CopperPilot/Jetson-AI-Cam-CopperPilot/docs/images/schematic-comparisons/page2_id_serial_after.png

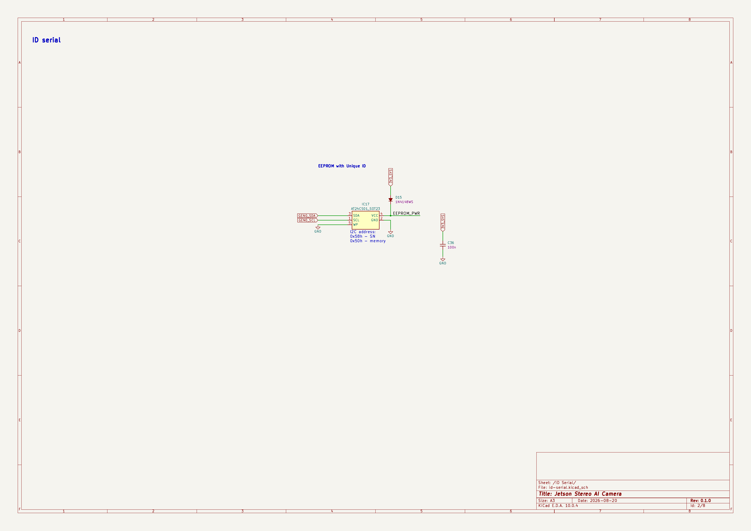
docs/images/schematic-comparisons/page2_id_serial_after.png
