CopperPilot/Jetson-AI-Cam-CopperPilot/docs/images/schematic-comparisons/page4_som_after.png

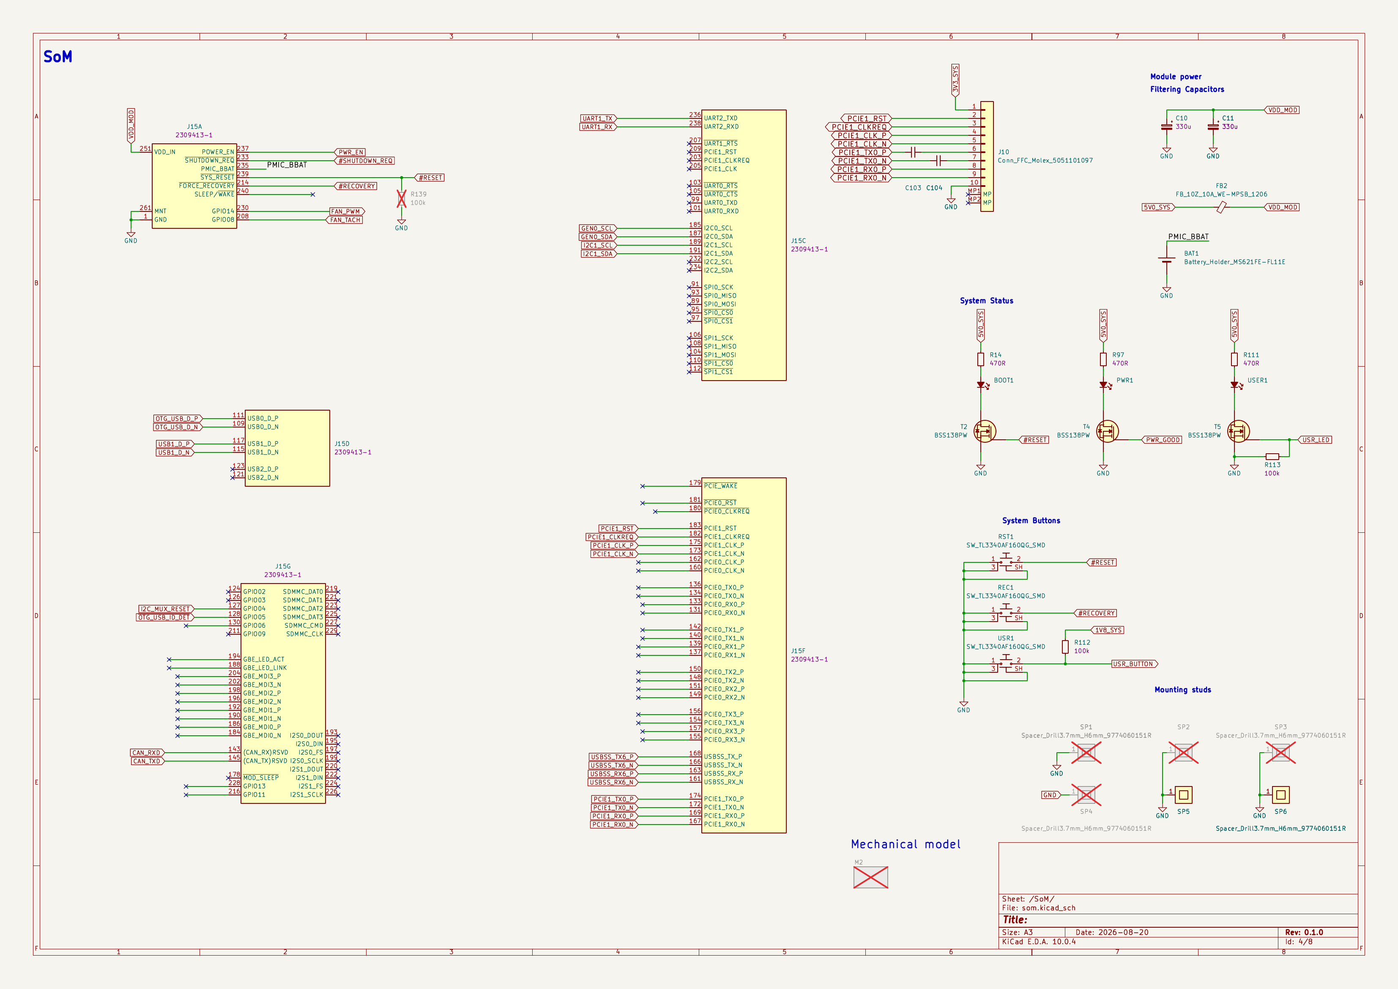
docs/images/schematic-comparisons/page4_som_after.png
