CopperPilot/Jetson-AI-Cam-CopperPilot/docs/images/schematic-comparisons/page6_supply_before.png

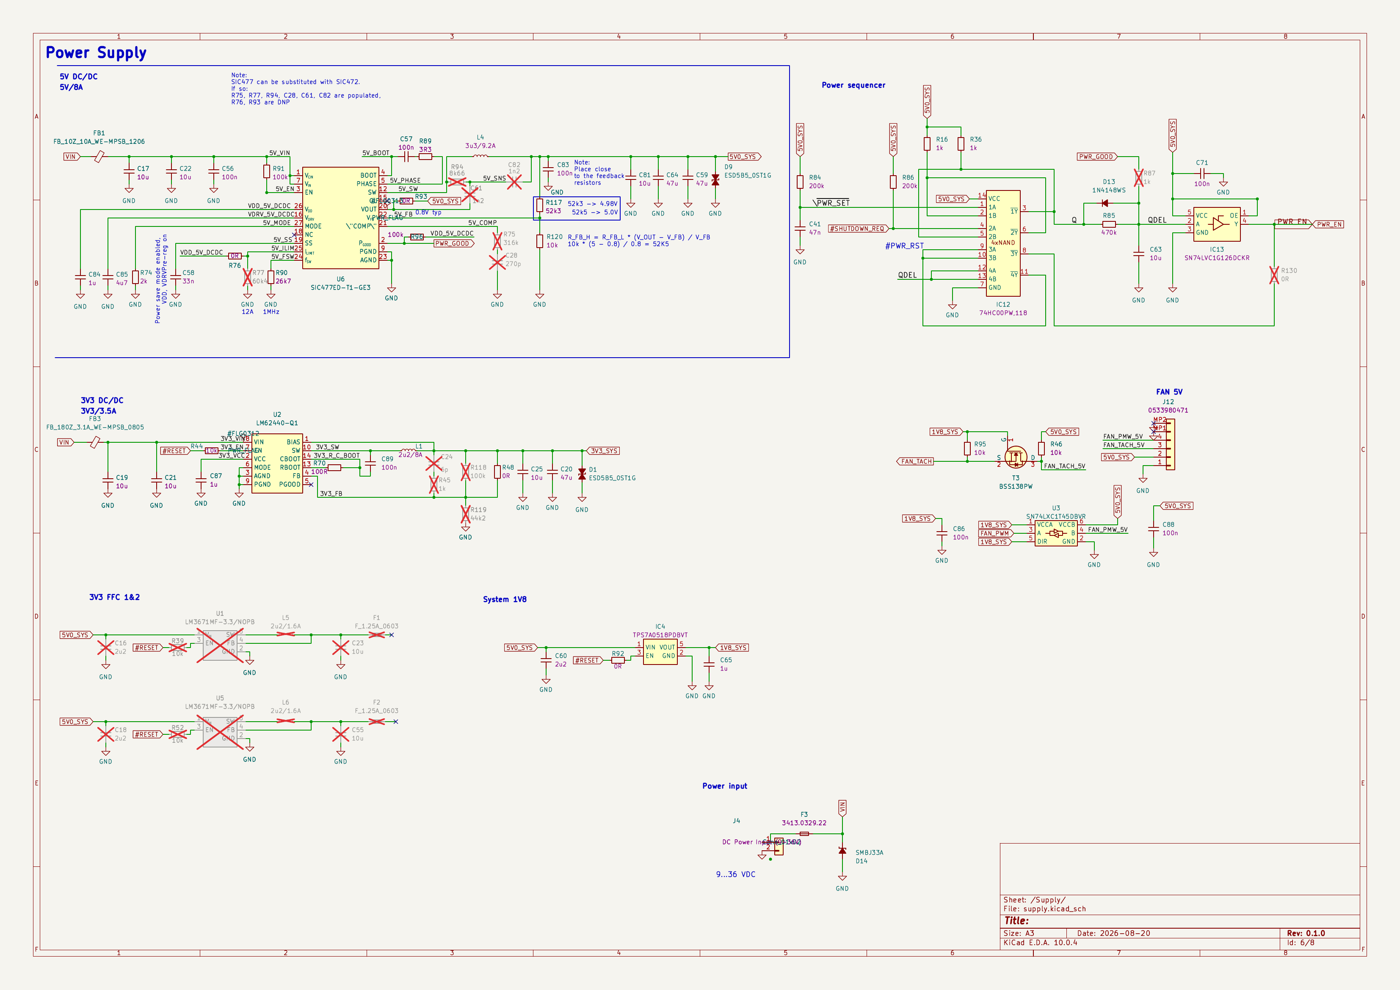
docs/images/schematic-comparisons/page6_supply_before.png
