CopperPilot/Jetson-AI-Cam-CopperPilot/docs/images/schematic-comparisons/page7_interfaces_after.png

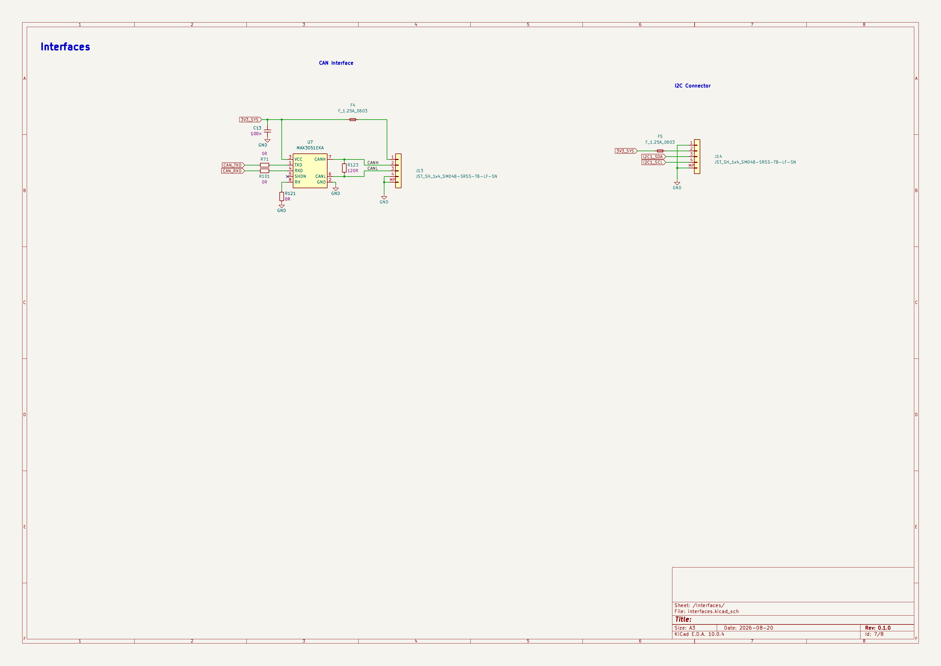
docs/images/schematic-comparisons/page7_interfaces_after.png
