CopperPilot/Jetson-AI-Cam-CopperPilot/docs/images/schematic-comparisons/page7_interfaces_comparison.png

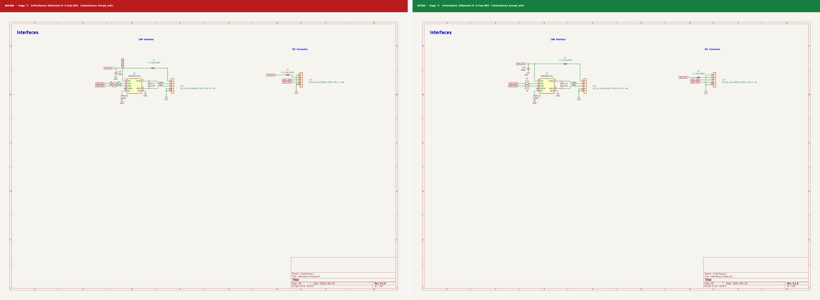
docs/images/schematic-comparisons/page7_interfaces_comparison.png
