CopperPilot/Jetson-AI-Cam-CopperPilot/review/renders/baseline/pcb_09_F_Mask.png

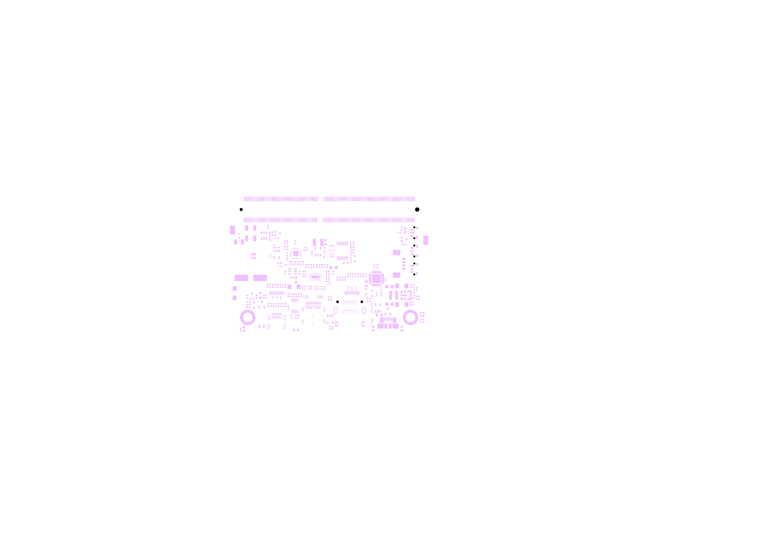
review/renders/baseline/pcb_09_F_Mask.png
