CopperPilot/Jetson-AI-Cam-CopperPilot/review/renders/baseline/sch_01_Root.png

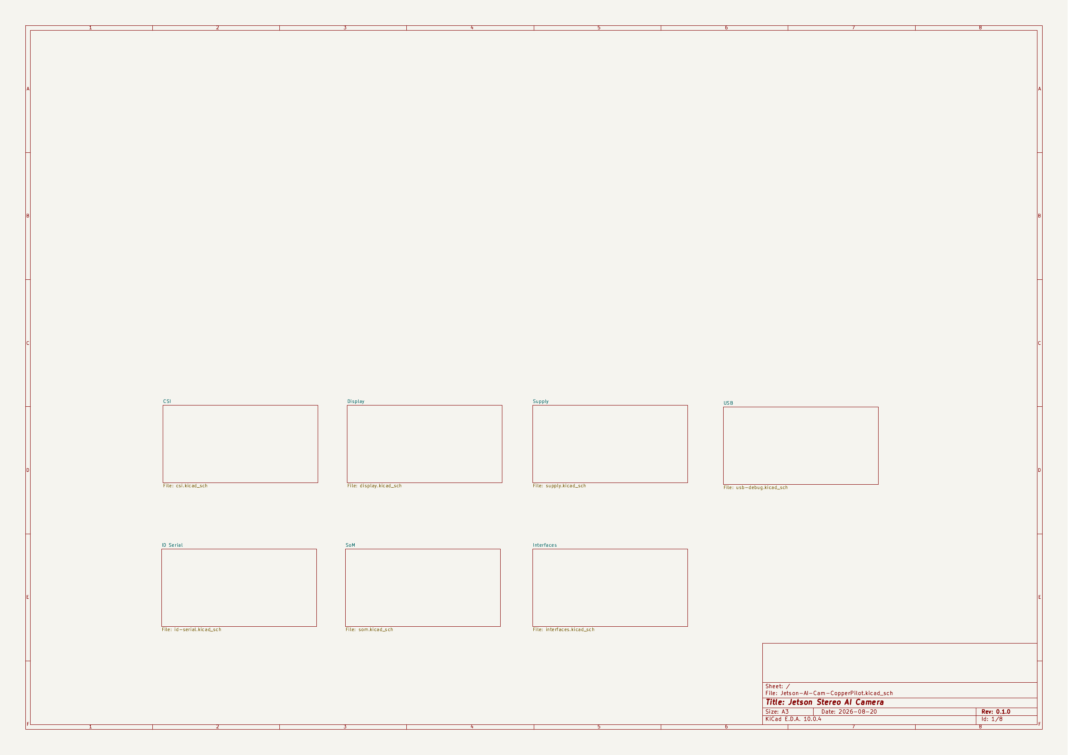
review/renders/baseline/sch_01_Root.png
