CopperPilot/Jetson-AI-Cam-CopperPilot/review/renders/baseline/sch_05_Display.png

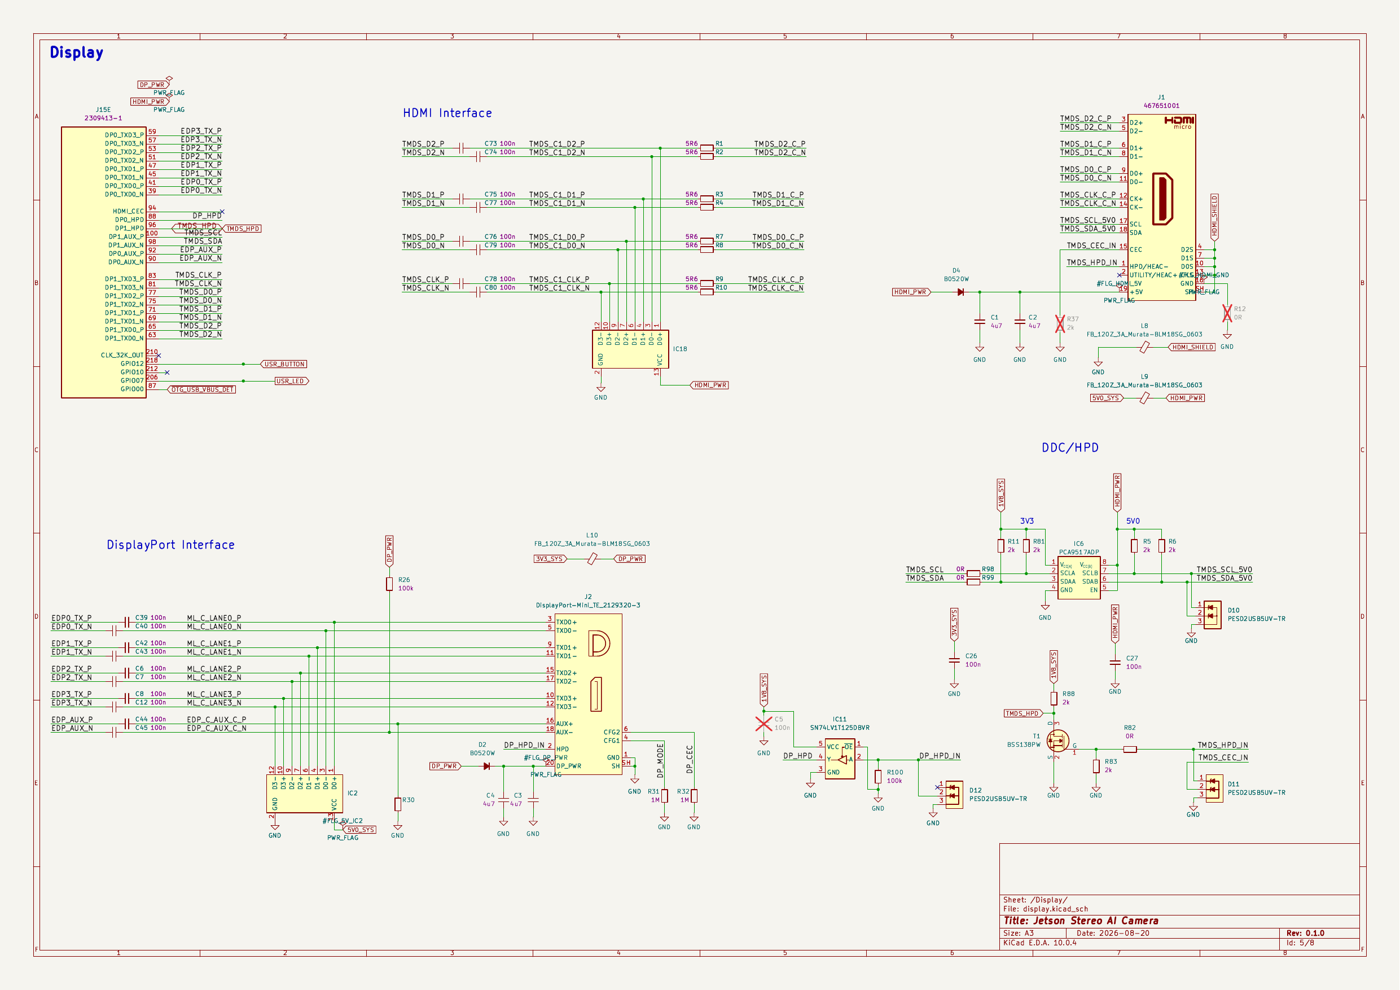
review/renders/baseline/sch_05_Display.png
