CopperPilot/Jetson-AI-Cam-CopperPilot/review/renders/deep_dive/3d_bottom_4k.png

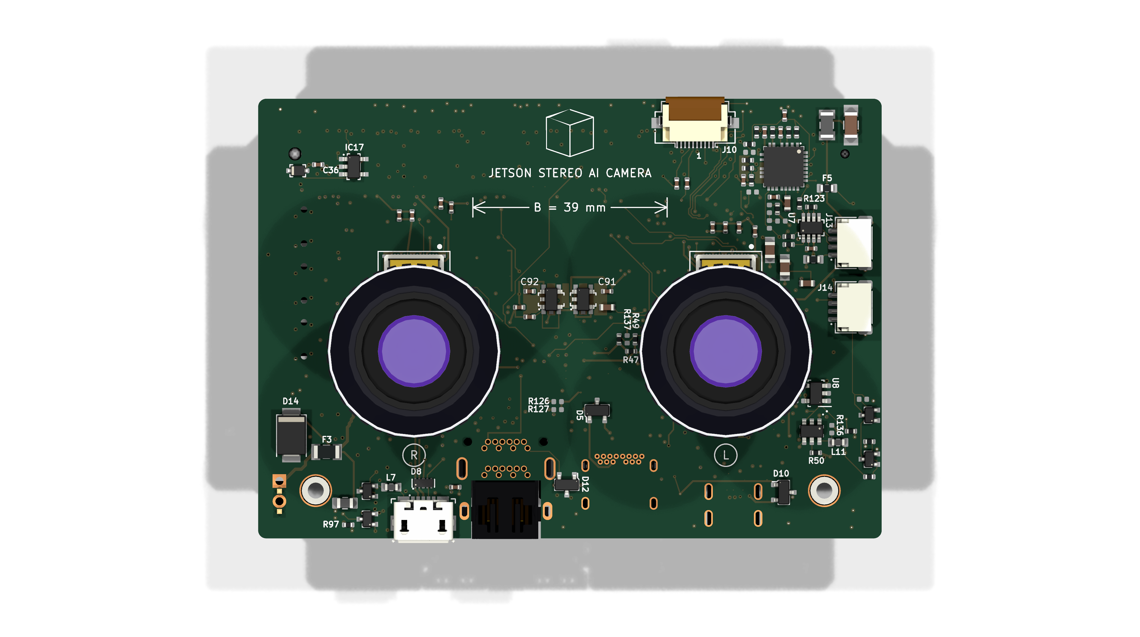
review/renders/deep_dive/3d_bottom_4k.png
