CopperPilot/Jetson-AI-Cam-CopperPilot/review/renders/deep_dive/zones/zone1_power_dc_dc_F_SilkS.png

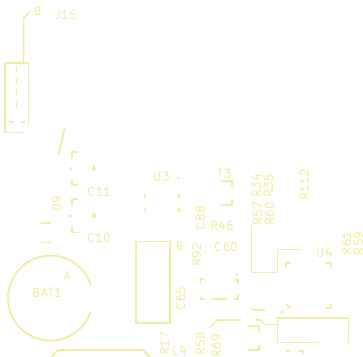
review/renders/deep_dive/zones/zone1_power_dc_dc_F_SilkS.png
