CopperPilot/Jetson-AI-Cam-CopperPilot/review/renders/deep_dive/zones/zone3_video_dp_hdmi_3D_Bottom.png

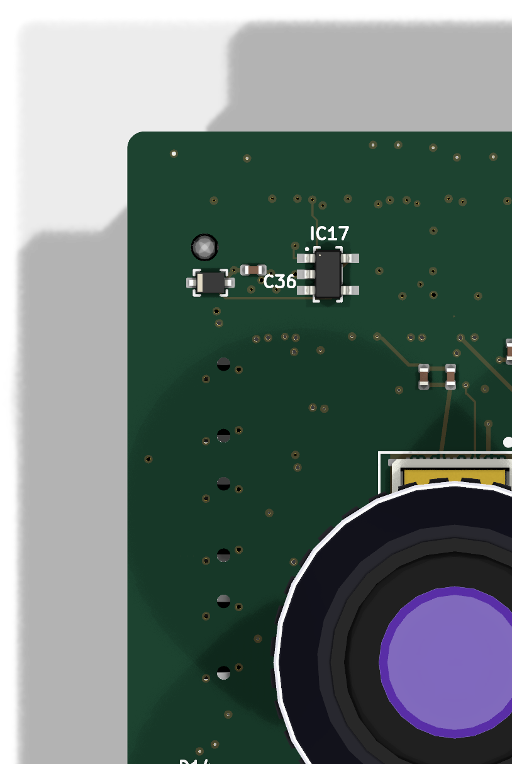
review/renders/deep_dive/zones/zone3_video_dp_hdmi_3D_Bottom.png
