CopperPilot/Jetson-AI-Cam-CopperPilot/review/renders/deep_dive/zones/zone3_video_dp_hdmi_In2_Signal.png

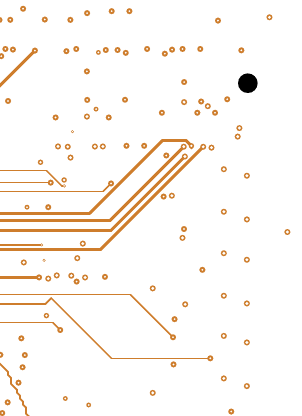
review/renders/deep_dive/zones/zone3_video_dp_hdmi_In2_Signal.png
