CopperPilot/Jetson-AI-Cam-CopperPilot/review/renders/deep_dive/zones/zone4_cameras_mipi_csi_In4_GND.png

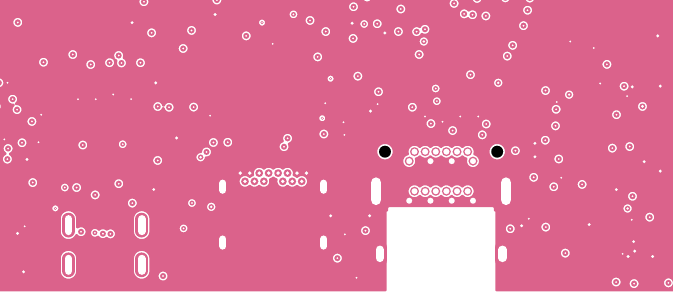
review/renders/deep_dive/zones/zone4_cameras_mipi_csi_In4_GND.png
