CopperPilot/Jetson-AI-Cam-CopperPilot/review/renders/deep_dive/zones/zone6_can_peripherals_F_Cu.png

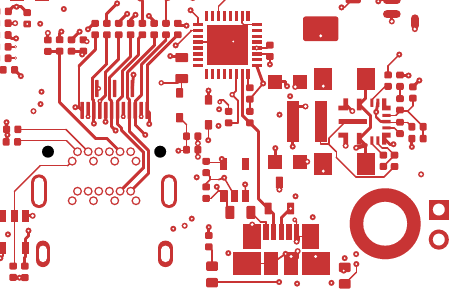
review/renders/deep_dive/zones/zone6_can_peripherals_F_Cu.png
