CopperPilot/Jetson-AI-Cam-CopperPilot/review/renders/deep_dive/zones/zone6_can_peripherals_In4_GND.png

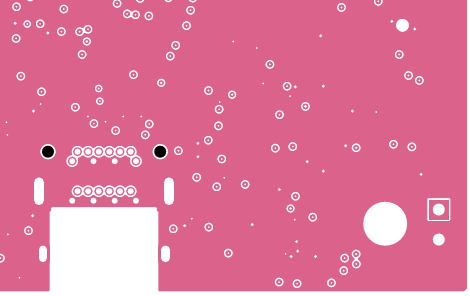
review/renders/deep_dive/zones/zone6_can_peripherals_In4_GND.png
