CopperPilot/Jetson-AI-Cam-CopperPilot/review/renders/diff/pcb_03_In2_Cu.png

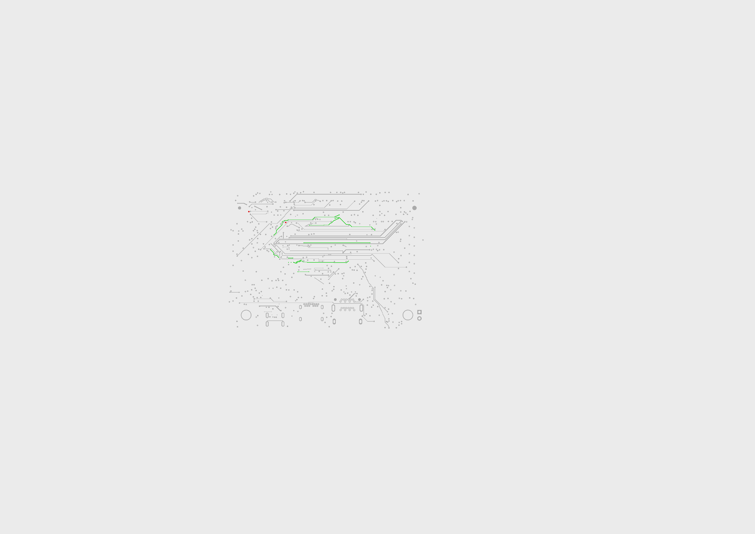
review/renders/diff/pcb_03_In2_Cu.png
