CopperPilot/Jetson-AI-Cam-CopperPilot/review/renders/diff/pcb_05_In4_Cu.png

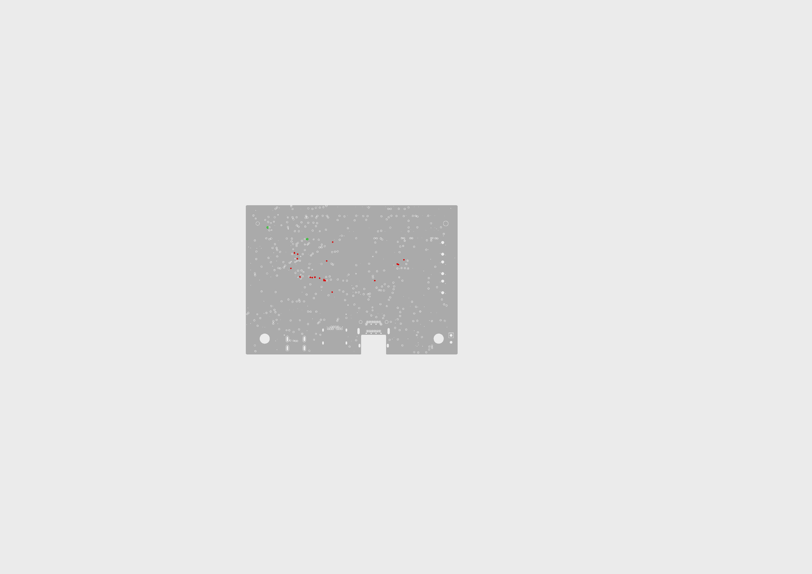
review/renders/diff/pcb_05_In4_Cu.png
