CopperPilot/Jetson-AI-Cam-CopperPilot/review/renders/diff/sch_01_Root.png

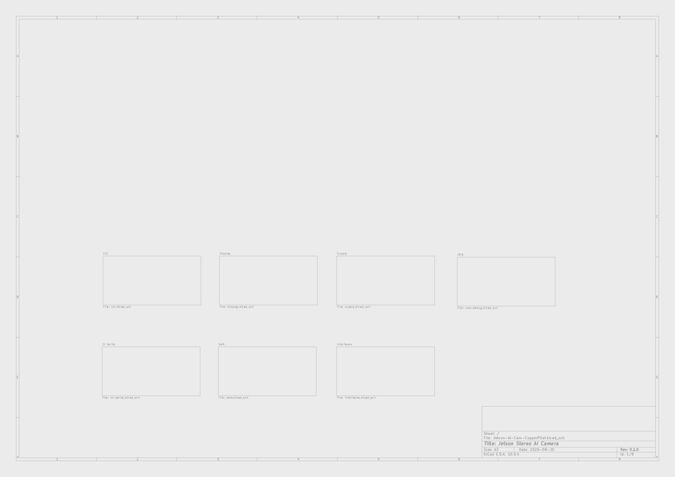
review/renders/diff/sch_01_Root.png
