CopperPilot/Jetson-AI-Cam-CopperPilot/review/renders/diff/sch_02_ID_Serial.png

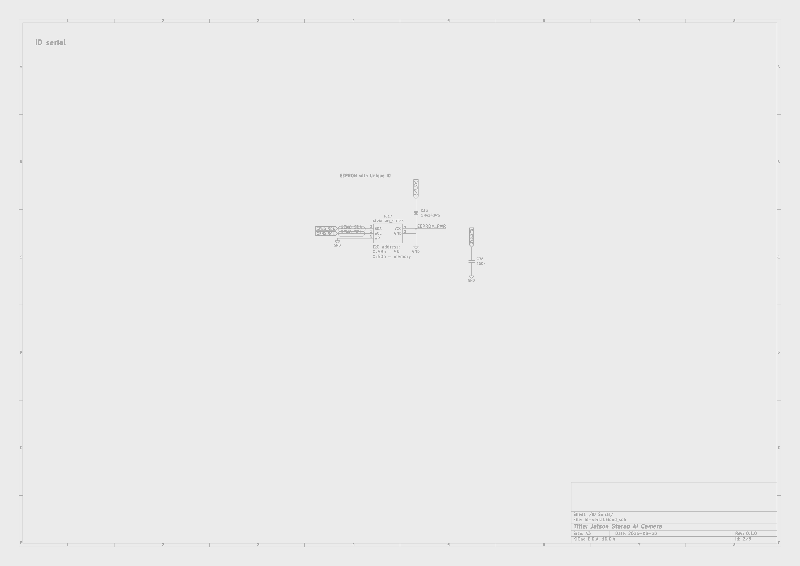
review/renders/diff/sch_02_ID_Serial.png
