CopperPilot/Jetson-AI-Cam-CopperPilot/review/renders/diff/sch_03_Interfaces.png

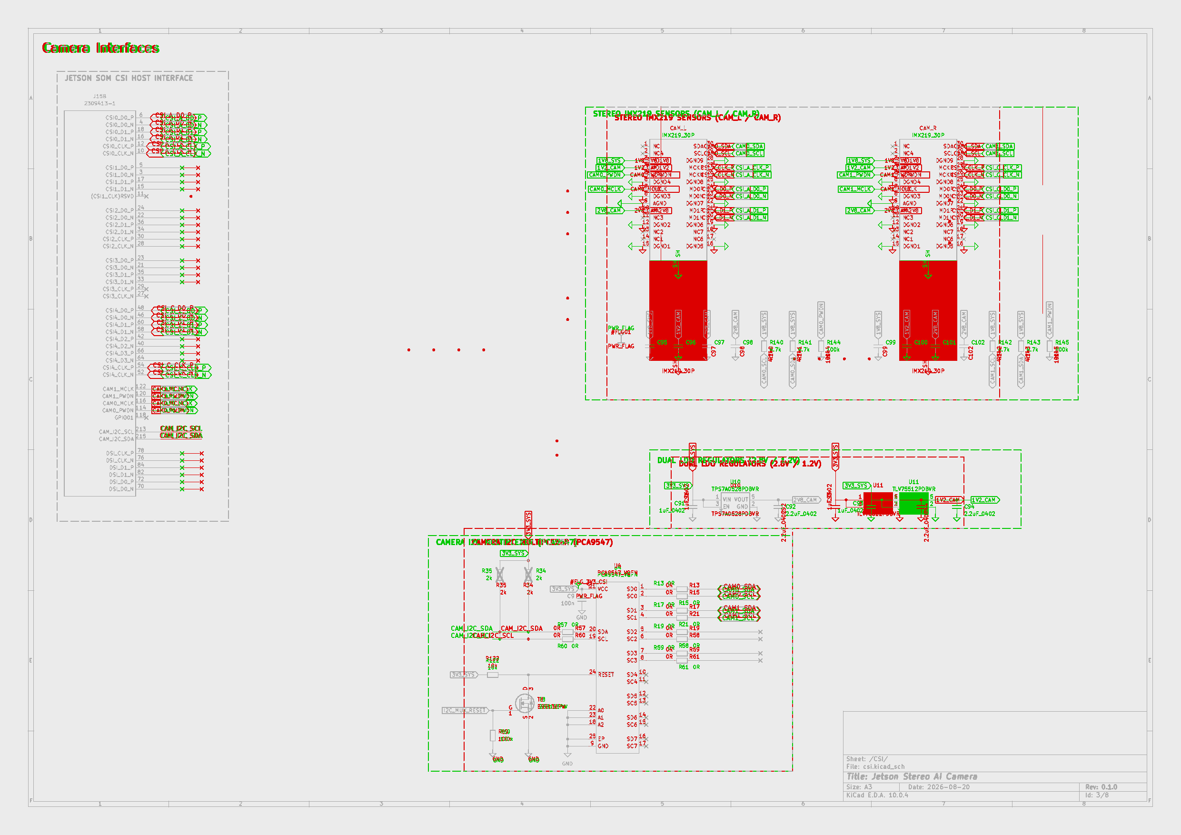
review/renders/diff/sch_03_Interfaces.png
