CopperPilot/Jetson-AI-Cam-CopperPilot/review/renders/diff/sch_04_SoM.png

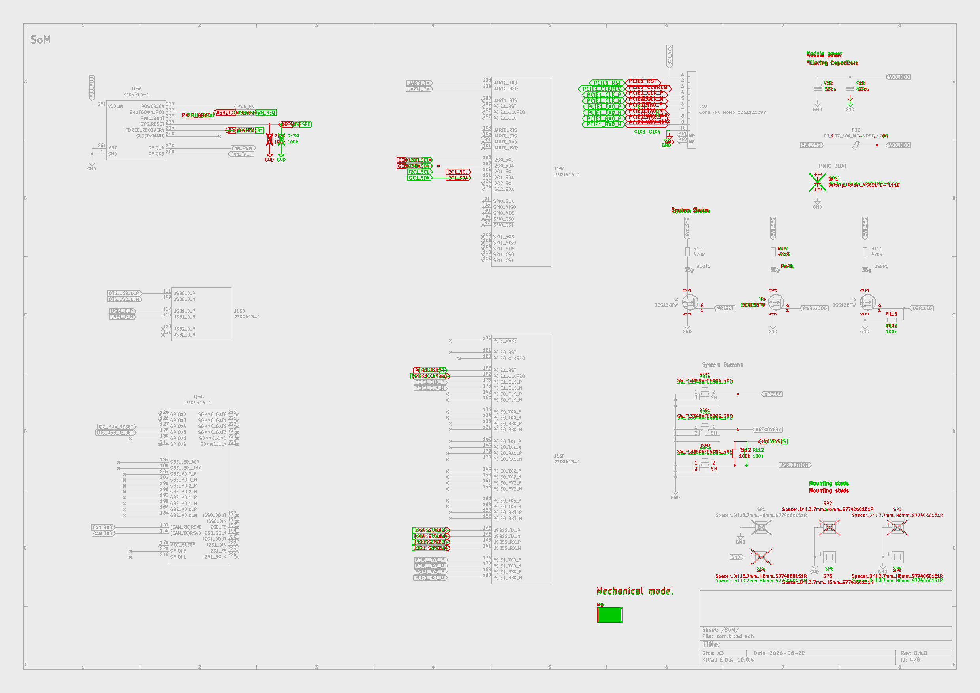
review/renders/diff/sch_04_SoM.png
