CopperPilot/Jetson-AI-Cam-CopperPilot/review/renders/diff/sch_06_Supply.png

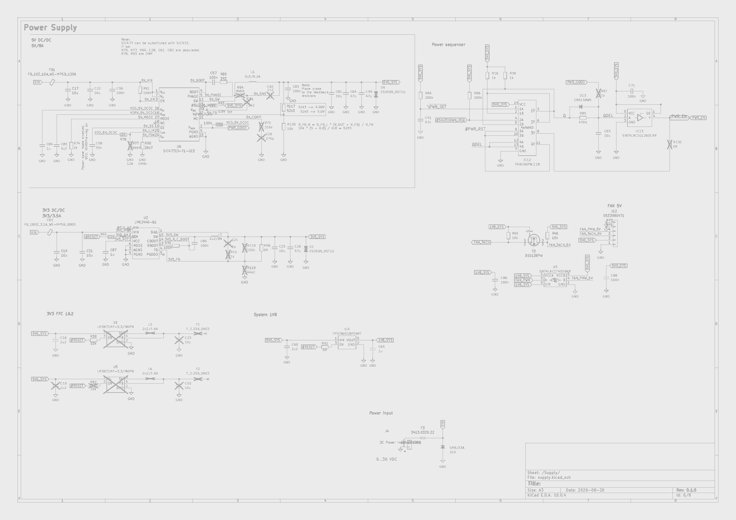
review/renders/diff/sch_06_Supply.png
