CopperPilot/Jetson-AI-Cam-CopperPilot/review/renders/diff/sch_07_CSI.png

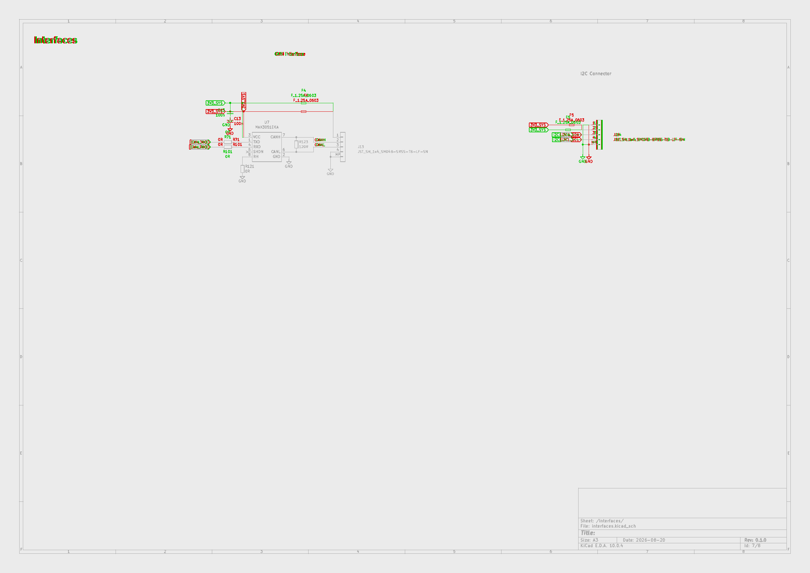
review/renders/diff/sch_07_CSI.png
