CopperPilot/Jetson-AI-Cam-CopperPilot/review/renders/diff/sch_08_USB.png

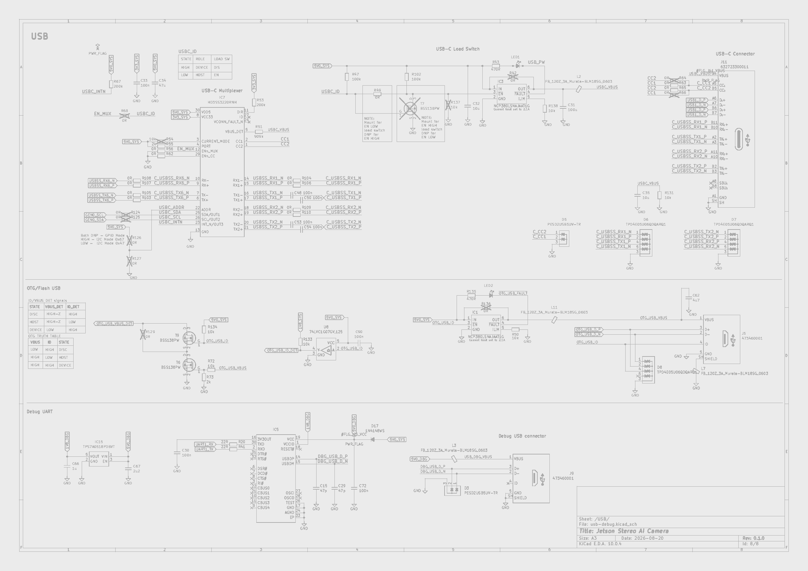
review/renders/diff/sch_08_USB.png
