CopperPilot/Jetson-AI-Cam-CopperPilot/review/renders/final/sch_01_Root.png

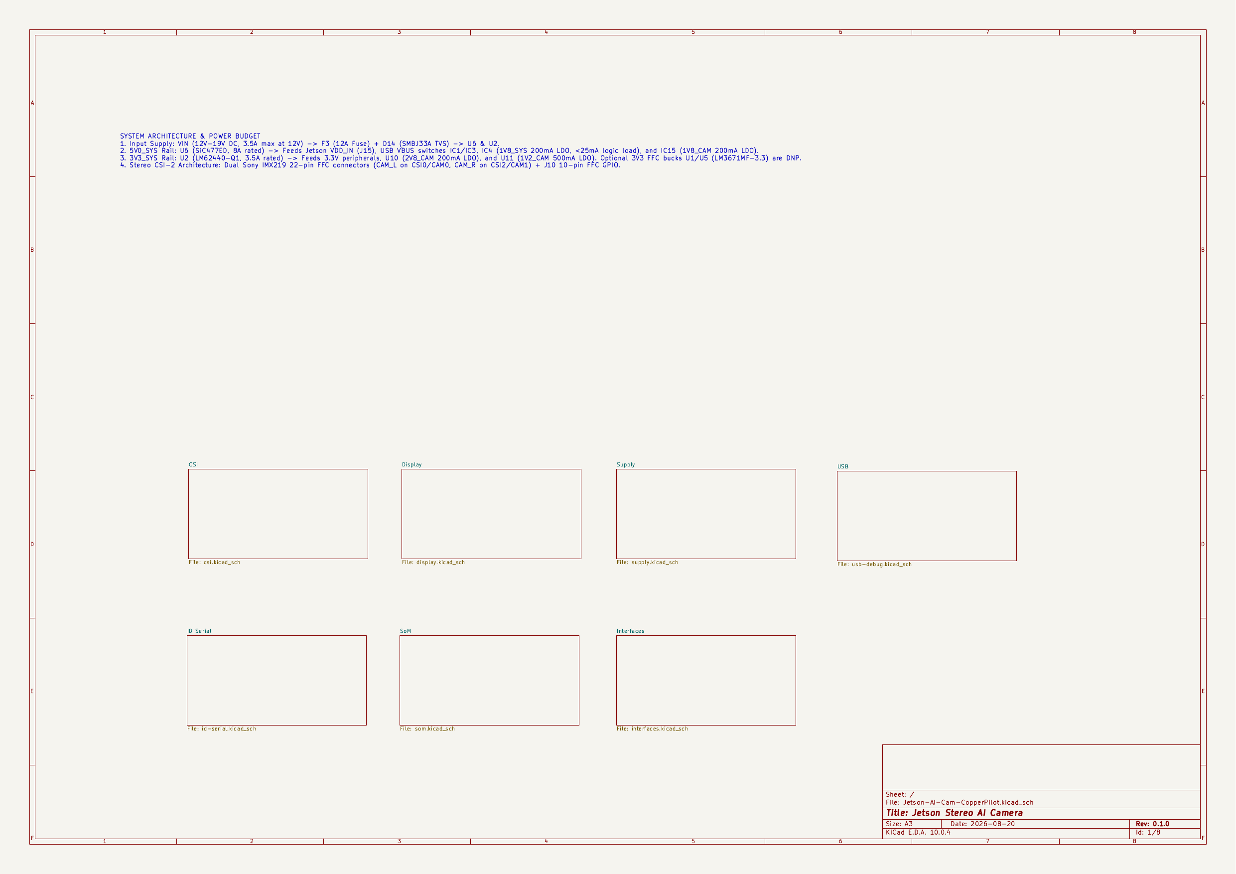
review/renders/final/sch_01_Root.png
