CopperPilot/Jetson-AI-Cam-CopperPilot/review/renders/final/sch_02_ID_Serial.png

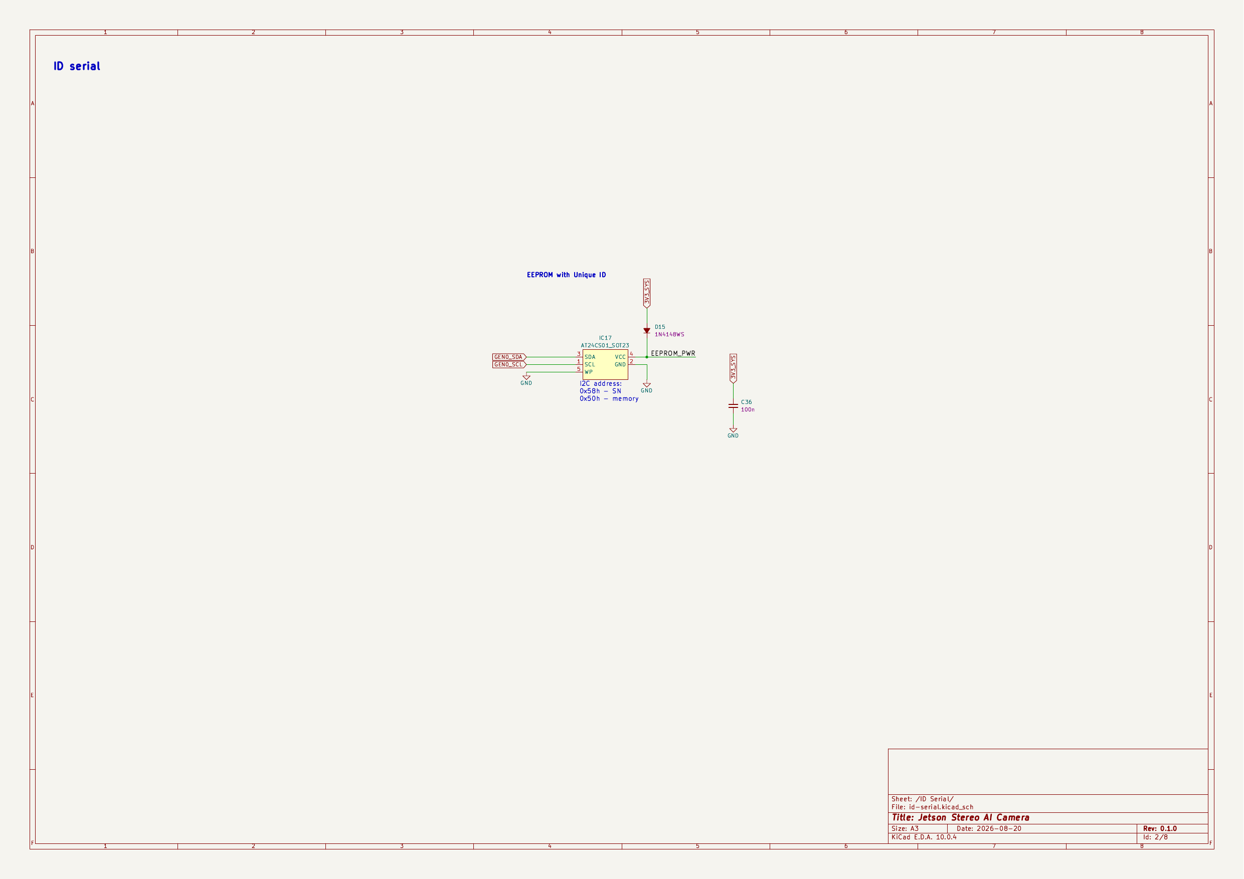
review/renders/final/sch_02_ID_Serial.png
