CopperPilot/Jetson-AI-Cam-CopperPilot/jlcpcb/Jetson-AI-Cam-CopperPilot-bom.csv

Designator | Value | Footprint | LCSC | MPN | DNP
BOOT1 | LED_G_0603_LG_L29K-G2J1-24-Z | jetson-footprints:LED_0603_1608Metric_G | C72043 | LG L29K-G2J1-24-Z
C1 | C_4u7_0402 | jetson-footprints:C_0402_1005Metric | C23733 | GRM155R61A475MEAAD
C2 | C_4u7_0402 | jetson-footprints:C_0402_1005Metric | C23733 | GRM155R61A475MEAAD
C3 | C_4u7_0402 | jetson-footprints:C_0402_1005Metric | C23733 | GRM155R61A475MEAAD
C4 | C_4u7_0402 | jetson-footprints:C_0402_1005Metric | C23733 | GRM155R61A475MEAAD
C5 | C_100n_0402 | jetson-footprints:C_0402_1005Metric | C1525 | GRM155R61H104KE14D
C6 | C_100n_0402 | jetson-footprints:C_0402_1005Metric | C1525 | GRM155R61H104KE14D
C7 | C_100n_0402 | jetson-footprints:C_0402_1005Metric | C1525 | GRM155R61H104KE14D
C8 | C_100n_0402 | jetson-footprints:C_0402_1005Metric | C1525 | GRM155R61H104KE14D
C9 | C_100n_0402 | jetson-footprints:C_0402_1005Metric | C1525 | GRM155R61H104KE14D
C10 | C_Pol_330u_6.3V_KEMET-T520-B | jetson-footprints:C_Pol_EIA-B | C134785 | T520B337M006ATE040
C11 | C_Pol_330u_6.3V_KEMET-T520-B | jetson-footprints:C_Pol_EIA-B | C134785 | T520B337M006ATE040
C12 | C_100n_0402 | jetson-footprints:C_0402_1005Metric | C1525 | GRM155R61H104KE14D
C13 | C_100n_0402 | jetson-footprints:C_0402_1005Metric | C1525 | GRM155R61H104KE14D
C15 | C_47p_0402 | jetson-footprints:C_0402_1005Metric | C1548 | C0402C470J5GACTU
C17 | C_10u_1206_50V | jetson-footprints:C_1206_3216Metric | C13585 | C3216X7R1H106K160AE
C19 | C_10u_1206_50V | jetson-footprints:C_1206_3216Metric | C13585 | C3216X7R1H106K160AE
C20 | C_47u_0805 | jetson-footprints:C_0805_2012Metric | C16780 | C0805C476M9PACTU
C21 | C_10u_1206_50V | jetson-footprints:C_1206_3216Metric | C13585 | C3216X7R1H106K160AE
C22 | C_10u_1206_50V | jetson-footprints:C_1206_3216Metric | C13585 | C3216X7R1H106K160AE
C24 | C_6p_0402 | jetson-footprints:C_0402_1005Metric | C1571 | 0402N6R0D500CT
C25 | C_10u_0805 | jetson-footprints:C_0805_2012Metric | C15850 | 160R15X106KV4E
C26 | C_100n_0402 | jetson-footprints:C_0402_1005Metric | C1525 | GRM155R61H104KE14D
C27 | C_100n_0402 | jetson-footprints:C_0402_1005Metric | C1525 | GRM155R61H104KE14D
C29 | C_47p_0402 | jetson-footprints:C_0402_1005Metric | C1548 | C0402C470J5GACTU
C30 | C_100n_0402 | jetson-footprints:C_0402_1005Metric | C1525 | GRM155R61H104KE14D
C31 | C_100u_1206 | jetson-footprints:C_1206_3216Metric | C15068 | GRM31CR60J107MEA8K
C32 | C_10u_0402 | jetson-footprints:C_0402_1005Metric | C15525 | CC0402MRX5R5BB106
C33 | C_100n_0402 | jetson-footprints:C_0402_1005Metric | C1525 | GRM155R61H104KE14D
C34 | C_47u_0805 | jetson-footprints:C_0805_2012Metric | C16780 | C0805C476M9PACTU
C35 | C_10u_0603 | jetson-footprints:C_0603_1608Metric | C19702 | GRM188R61A106KE69D
C36 | C_100n_0402 | jetson-footprints:C_0402_1005Metric | C1525 | GRM155R61H104KE14D
C39 | C_100n_0402 | jetson-footprints:C_0402_1005Metric | C1525 | GRM155R61H104KE14D
C40 | C_100n_0402 | jetson-footprints:C_0402_1005Metric | C1525 | GRM155R61H104KE14D
C41 | C_47n_0402 | jetson-footprints:C_0402_1005Metric | C1536 | GRM155R71C473KA01D
C42 | C_100n_0402 | jetson-footprints:C_0402_1005Metric | C1525 | GRM155R61H104KE14D
C43 | C_100n_0402 | jetson-footprints:C_0402_1005Metric | C1525 | GRM155R61H104KE14D
C44 | C_100n_0402 | jetson-footprints:C_0402_1005Metric | C1525 | GRM155R61H104KE14D
C45 | C_100n_0402 | jetson-footprints:C_0402_1005Metric | C1525 | GRM155R61H104KE14D
C48 | C_100n_0402 | jetson-footprints:C_0402_1005Metric | C1525 | GRM155R61H104KE14D
C50 | C_100n_0402 | jetson-footprints:C_0402_1005Metric | C1525 | GRM155R61H104KE14D
C53 | C_100n_0402 | jetson-footprints:C_0402_1005Metric | C1525 | GRM155R61H104KE14D
C54 | C_100n_0402 | jetson-footprints:C_0402_1005Metric | C1525 | GRM155R61H104KE14D
C56 | C_100n_50V_0402 | jetson-footprints:C_0402_1005Metric | C307331 | GRM155R71H104KE14D
C57 | C_100n_0402 | jetson-footprints:C_0402_1005Metric | C1525 | GRM155R61H104KE14D
C58 | C_33n_0402 | jetson-footprints:C_0402_1005Metric | C1533 | GCM155R71E333KA55D
C59 | C_47u_0805 | jetson-footprints:C_0805_2012Metric | C16780 | C0805C476M9PACTU
C60 | C_2u2_0402 | jetson-footprints:C_0402_1005Metric | C12530 | C1005X5R1A225K050BC
C62 | C_4u7_0402 | jetson-footprints:C_0402_1005Metric | C23733 | GRM155R61A475MEAAD
C63 | C_10u_0603 | jetson-footprints:C_0603_1608Metric | C19702 | GRM188R61A106KE69D
C64 | C_47u_0805 | jetson-footprints:C_0805_2012Metric | C16780 | C0805C476M9PACTU
C65 | C_1u_0402 | jetson-footprints:C_0402_1005Metric | C52923 | C1005X6S1A105K050BC
C66 | C_1u_0402 | jetson-footprints:C_0402_1005Metric | C52923 | C1005X6S1A105K050BC
C67 | C_2u2_0402 | jetson-footprints:C_0402_1005Metric | C12530 | C1005X5R1A225K050BC
C71 | C_100n_0402 | jetson-footprints:C_0402_1005Metric | C1525 | GRM155R61H104KE14D
C72 | C_100n_0402 | jetson-footprints:C_0402_1005Metric | C1525 | GRM155R61H104KE14D
C73 | C_100n_0402 | jetson-footprints:C_0402_1005Metric | C1525 | GRM155R61H104KE14D
C74 | C_100n_0402 | jetson-footprints:C_0402_1005Metric | C1525 | GRM155R61H104KE14D
C75 | C_100n_0402 | jetson-footprints:C_0402_1005Metric | C1525 | GRM155R61H104KE14D
C76 | C_100n_0402 | jetson-footprints:C_0402_1005Metric | C1525 | GRM155R61H104KE14D
C77 | C_100n_0402 | jetson-footprints:C_0402_1005Metric | C1525 | GRM155R61H104KE14D
C78 | C_100n_0402 | jetson-footprints:C_0402_1005Metric | C1525 | GRM155R61H104KE14D
C79 | C_100n_0402 | jetson-footprints:C_0402_1005Metric | C1525 | GRM155R61H104KE14D
C80 | C_100n_0402 | jetson-footprints:C_0402_1005Metric | C1525 | GRM155R61H104KE14D
C81 | C_10u_0603 | jetson-footprints:C_0603_1608Metric | C19702 | GRM188R61A106KE69D
C83 | C_100n_0402 | jetson-footprints:C_0402_1005Metric | C1525 | GRM155R61H104KE14D
C84 | C_1u_0402 | jetson-footprints:C_0402_1005Metric | C52923 | C1005X6S1A105K050BC
C85 | C_4u7_0603 | jetson-footprints:C_0603_1608Metric | C19666 | C1608X5R1V475M080AC
C86 | C_100n_0402 | jetson-footprints:C_0402_1005Metric | C1525 | GRM155R61H104KE14D
C87 | C_1u_0402 | jetson-footprints:C_0402_1005Metric | C52923 | C1005X6S1A105K050BC
C88 | C_100n_0402 | jetson-footprints:C_0402_1005Metric | C1525 | GRM155R61H104KE14D
C89 | C_100n_0402 | jetson-footprints:C_0402_1005Metric | C1525 | GRM155R61H104KE14D
C90 | C_100n_0402 | jetson-footprints:C_0402_1005Metric | C1525 | GRM155R61H104KE14D
C91 | 1uF_0402 | jetson-footprints:C_0402_1005Metric | C52923 | C1005X6S1A105K050BC
C92 | 2.2uF_0402 | jetson-footprints:C_0402_1005Metric | C12530 | C1005X5R1A225K050BC
C93 | 1uF_0402 | jetson-footprints:C_0402_1005Metric | C52923 | C1005X6S1A105K050BC
C94 | 2.2uF_0402 | jetson-footprints:C_0402_1005Metric | C12530 | C1005X5R1A225K050BC
C95 | C_100n_0402 | jetson-footprints:C_0402_1005Metric | C1525 | GRM155R61H104KE14D
C96 | C_100n_0402 | jetson-footprints:C_0402_1005Metric | C1525 | GRM155R61H104KE14D
C97 | C_100n_0402 | jetson-footprints:C_0402_1005Metric | C1525 | GRM155R61H104KE14D
C98 | C_2u2_0402 | jetson-footprints:C_0402_1005Metric | C12530 | C1005X5R1A225K050BC
C99 | C_100n_0402 | jetson-footprints:C_0402_1005Metric | C1525 | GRM155R61H104KE14D
C100 | C_100n_0402 | jetson-footprints:C_0402_1005Metric | C1525 | GRM155R61H104KE14D
C101 | C_100n_0402 | jetson-footprints:C_0402_1005Metric | C1525 | GRM155R61H104KE14D
C102 | C_2u2_0402 | jetson-footprints:C_0402_1005Metric | C12530 | C1005X5R1A225K050BC
C103 | C_100n_0402 | jetson-footprints:C_0402_1005Metric | C1525 | GRM155R61H104KE14D
C104 | C_100n_0402 | jetson-footprints:C_0402_1005Metric | C1525 | GRM155R61H104KE14D
CAM_L | IMX219_30P | jetson-footprints:Camera_Module_IMX219-D160 | C424662 | BM20B(0.8)-30DS-0.4V(51)
CAM_R | IMX219_30P | jetson-footprints:Camera_Module_IMX219-D160 | C424662 | BM20B(0.8)-30DS-0.4V(51)
D1 | ESD5B5_0ST1G | jetson-footprints:SOD-523_NP | C15906 | ESD5B5.0ST1G
D2 | B0520W | jetson-footprints:D_SOD-323F | C8598 | B0520W
D3 | PESD2USB5UV-TR | jetson-footprints:SOT-23-3 | C2827695 | PESD2USB5UV-TR
D4 | B0520W | jetson-footprints:D_SOD-323F | C8598 | B0520W
D5 | PESD2USB5UV-TR | jetson-footprints:SOT-23-3 | C2827695 | PESD2USB5UV-TR
D6 | TPD4E05U06QDQARQ1 | jetson-footprints:USON-10_2.5x1mm_P0.5mm | C138252 | TPD4E05U06QDQARQ1
D7 | TPD4E05U06QDQARQ1 | jetson-footprints:USON-10_2.5x1mm_P0.5mm | C138252 | TPD4E05U06QDQARQ1
D8 | TPD4E05U06QDQARQ1 | jetson-footprints:USON-10_2.5x1mm_P0.5mm | C138252 | TPD4E05U06QDQARQ1
D9 | ESD5B5_0ST1G | jetson-footprints:SOD-523_NP | C15906 | ESD5B5.0ST1G
D10 | PESD2USB5UV-TR | jetson-footprints:SOT-23-3 | C2827695 | PESD2USB5UV-TR
D11 | PESD2USB5UV-TR | jetson-footprints:SOT-23-3 | C2827695 | PESD2USB5UV-TR
D12 | PESD2USB5UV-TR | jetson-footprints:SOT-23-3 | C2827695 | PESD2USB5UV-TR
D13 | 1N4148WS | jetson-footprints:D_SOD-323F | C2128 | 1N4148WS
D14 | SMBJ33A | jetson-footprints:D_SMB | C123805 | SMBJ33A
D15 | 1N4148WS | jetson-footprints:D_SOD-323F | C2128 | 1N4148WS
D17 | 1N4148WS | jetson-footprints:D_SOD-323F | C2128 | 1N4148WS
F3 | F_12A_1206 | jetson-footprints:F_1206_3216Metric | C269188 | 3413.0329.22
F4 | F_1.25A_0603 | jetson-footprints:F_0603_1608Metric | C150891 | 04671.25NR
F5 | F_1.25A_0603 | jetson-footprints:F_0603_1608Metric | C150891 | 04671.25NR
FB1 | FB_10Z_10A_WE-MPSB_1206 | jetson-footprints:FB_1206_3216Metric | C145764 | 74279221100
FB2 | FB_10Z_10A_WE-MPSB_1206 | jetson-footprints:FB_1206_3216Metric | C145764 | 74279221100
FB3 | FB_180Z_3.1A_WE-MPSB_0805 | jetson-footprints:FB_0805_2012Metric | C145762 | 74279220181
IC1 | NCP380LSNAJAAT1G | jetson-footprints:SOT-23-6 | C140656 | NCP380LSNAJAAT1G
IC2 | TPD8S009DSMR | jetson-footprints:R-PDSO-N15 | C139543 | TPD8S009DSMR
IC3 | NCP380LSNAJAAT1G | jetson-footprints:SOT-23-6 | C140656 | NCP380LSNAJAAT1G
IC4 | TPS7A0518P_SOT23-5 | jetson-footprints:SOT-23-5 | C194385 | TPS7A0518PDBVT
IC5 | FT232R_QFN | jetson-footprints:QFN-32-1EP_5x5mm | C51997 | FT232RQ-REEL
IC6 | PCA9517ADP | jetson-footprints:TSSOP-8_3x3mm_P0.65mm | C112457 | PCA9517ADP
IC7 | HD3SS3220RNH | jetson-footprints:WQFN-30-1EP_4.6x2.6mm_P0.4mm | C131361 | HD3SS3220RNHT
IC11 | SN74LV1T125DBVR | jetson-footprints:SOT-23-5 | C100024 | SN74LV1T125DBVR
IC12 | 74HC00_TSSOP | jetson-footprints:TSSOP-14_4.4x5mm_P0.65mm | C7062 | 74HC00PW,118
IC13 | SN74LVC1G126_SC-70 | jetson-footprints:SC-70-5 | C7823 | SN74LVC1G126DCKR
IC15 | TPS7A0518P_SOT23-5 | jetson-footprints:SOT-23-5 | C194385 | TPS7A0518PDBVT
IC17 | AT24CS01_SOT23 | jetson-footprints:SOT-23-5 | C500682 | AT24CS01-ST
IC18 | TPD8S009DSMR | jetson-footprints:R-PDSO-N15 | C139543 | TPD8S009DSMR
J1 | HDMI-Micro-D_Molex_467561001 | jetson-footprints:HDMI-Micro-D_Receptacle_Molex_467651001 | C563878 | 467651001
J2 | DisplayPort-Mini_TE_2129320-3 | jetson-footprints:DisplayPort-Mini_Receptacle_TE_2129320-3 | C574827 | 2129320-3
J4 | Conn_01x02 | jetson-footprints:PinHeader_1x02_P2.54mm_Vertical | C492401 | TSW-102-07-L-S
J5 | USB-Micro-B_Molex_473460001 | jetson-footprints:USB-Micro-B_Receptacle_Molex_473460001 | C132560 | 473460001
J9 | USB-Micro-B_Molex_473460001 | jetson-footprints:USB-Micro-B_Receptacle_Molex_473460001 | C132560 | 473460001
J10 | Conn_FFC_Molex_5051101097 | jetson-footprints:Conn_FFC_Molex_5051101097 | C283651 | 5051101097
J11 | USB-C_WE_632723300011 | jetson-footprints:USB-C_Receptacle_WE_632723300011 | C456013 | 632723300011
J12 | Molex_PicoBlade_1x4_0533980471 | jetson-footprints:Conn_Molex_PicoBlade_1x4_0533980471 | C134090 | 0533980471
J13 | JST_SH_1x4_SM04B-SRSS-TB-LF-SN | jetson-footprints:Conn_JST_SH_1x4_SM04B-SRSS-TB-LF-SN | C160404 | SM04B-SRSS-TB(LF)(SN)
J14 | JST_SH_1x4_SM04B-SRSS-TB-LF-SN | jetson-footprints:Conn_JST_SH_1x4_SM04B-SRSS-TB-LF-SN | C160404 | SM04B-SRSS-TB(LF)(SN)
J15 | Bus_DDR4_SODIMM_CUSTOM_Jetson-Nano-H9.2mm-socket | jetson-footprints:TE_2309413 | C2766246 | 2309413-1
L1 | L_2u2_8A_Coilcraft-XFL4020 | jetson-footprints:L_Coilcraft-XFL4020 | C503516 | XFL4020-222MEC
L2 | FB_120Z_3A_Murata-BLM18SG_0603 | jetson-footprints:FB_0603_1608Metric | C73884 | BLM18SG121TN1D
L3 | FB_120Z_3A_Murata-BLM18SG_0603 | jetson-footprints:FB_0603_1608Metric | C73884 | BLM18SG121TN1D
L4 | L_3u3_9.2A_Vishay-IHLP-3232DZ-01 | jetson-footprints:L_Vishay-IHLP3232DZ | C139365 | IHLP3232DZER3R3M01
L7 | FB_120Z_3A_Murata-BLM18SG_0603 | jetson-footprints:FB_0603_1608Metric | C73884 | BLM18SG121TN1D
L8 | FB_120Z_3A_Murata-BLM18SG_0603 | jetson-footprints:FB_0603_1608Metric | C73884 | BLM18SG121TN1D
L9 | FB_120Z_3A_Murata-BLM18SG_0603 | jetson-footprints:FB_0603_1608Metric | C73884 | BLM18SG121TN1D
L10 | FB_120Z_3A_Murata-BLM18SG_0603 | jetson-footprints:FB_0603_1608Metric | C73884 | BLM18SG121TN1D
L11 | FB_120Z_3A_Murata-BLM18SG_0603 | jetson-footprints:FB_0603_1608Metric | C73884 | BLM18SG121TN1D
LED1 | LED_G_0603_LG_L29K-G2J1-24-Z | jetson-footprints:LED_0603_1608Metric_G | C72043 | LG L29K-G2J1-24-Z
LED2 | LED_G_0603_LG_L29K-G2J1-24-Z | jetson-footprints:LED_0603_1608Metric_G | C72043 | LG L29K-G2J1-24-Z
PWR1 | LED_G_0603_LG_L29K-G2J1-24-Z | jetson-footprints:LED_0603_1608Metric_G | C72043 | LG L29K-G2J1-24-Z
R1 | R_5R6_0402 | jetson-footprints:R_0402_1005Metric | C25122 | CR0402-FX-5R60GLF
R2 | R_5R6_0402 | jetson-footprints:R_0402_1005Metric | C25122 | CR0402-FX-5R60GLF
R3 | R_5R6_0402 | jetson-footprints:R_0402_1005Metric | C25122 | CR0402-FX-5R60GLF
R4 | R_5R6_0402 | jetson-footprints:R_0402_1005Metric | C25122 | CR0402-FX-5R60GLF
R5 | R_2k_0402 | jetson-footprints:R_0402_1005Metric | C4109 | CR0402-FX-2001GLF
R6 | R_2k_0402 | jetson-footprints:R_0402_1005Metric | C4109 | CR0402-FX-2001GLF
R7 | R_5R6_0402 | jetson-footprints:R_0402_1005Metric | C25122 | CR0402-FX-5R60GLF
R8 | R_5R6_0402 | jetson-footprints:R_0402_1005Metric | C25122 | CR0402-FX-5R60GLF
R9 | R_5R6_0402 | jetson-footprints:R_0402_1005Metric | C25122 | CR0402-FX-5R60GLF
R10 | R_5R6_0402 | jetson-footprints:R_0402_1005Metric | C25122 | CR0402-FX-5R60GLF
R11 | R_2k_0402 | jetson-footprints:R_0402_1005Metric | C4109 | CR0402-FX-2001GLF
R13 | R_0R_0402 | jetson-footprints:R_0402_1005Metric | C17168 | ERJ2GE0R00X
R14 | R_470R_0402 | jetson-footprints:R_0402_1005Metric | C25117 | CR0402-FX-4700GLF
R15 | R_0R_0402 | jetson-footprints:R_0402_1005Metric | C17168 | ERJ2GE0R00X
R16 | R_1k_0402 | jetson-footprints:R_0402_1005Metric | C11702 | CR0402-FX-1001GLF
R17 | R_0R_0402 | jetson-footprints:R_0402_1005Metric | C17168 | ERJ2GE0R00X
R19 | R_0R_0402 | jetson-footprints:R_0402_1005Metric | C17168 | ERJ2GE0R00X
R20 | R_22R_0402 | jetson-footprints:R_0402_1005Metric | C25092 | CR0402-FX-22R0GLF
R21 | R_0R_0402 | jetson-footprints:R_0402_1005Metric | C17168 | ERJ2GE0R00X
R26 | R_100k_0402 | jetson-footprints:R_0402_1005Metric | C25741 | CR0402-FX-1003GLF
R30 | R_100k_0402 | jetson-footprints:R_0402_1005Metric | C25741 | CR0402-FX-1003GLF
R31 | R_1M_0402 | jetson-footprints:R_0402_1005Metric | C26083 | CR0402-FX-1004GLF
R32 | R_1M_0402 | jetson-footprints:R_0402_1005Metric | C26083 | CR0402-FX-1004GLF
R36 | R_1k_0402 | jetson-footprints:R_0402_1005Metric | C11702 | CR0402-FX-1001GLF
R41 | R_22R_0402 | jetson-footprints:R_0402_1005Metric | C25092 | CR0402-FX-22R0GLF
R43 | R_470R_0402 | jetson-footprints:R_0402_1005Metric | C25117 | CR0402-FX-4700GLF
R44 | R_10k_0402 | jetson-footprints:R_0402_1005Metric | C25744 | CR0402-FX-1002GLF
R45 | R_1k_0402 | jetson-footprints:R_0402_1005Metric | C11702 | CR0402-FX-1001GLF
R46 | R_10k_0402 | jetson-footprints:R_0402_1005Metric | C25744 | CR0402-FX-1002GLF
R47 | R_100k_0402 | jetson-footprints:R_0402_1005Metric | C25741 | CR0402-FX-1003GLF
R49 | R_0R_0402 | jetson-footprints:R_0402_1005Metric | C17168 | ERJ2GE0R00X
R50 | R_10k_0402 | jetson-footprints:R_0402_1005Metric | C25744 | CR0402-FX-1002GLF
R51 | R_909k_0402 | jetson-footprints:R_0402_1005Metric | C25788 | CR0402-FX-9093GLF
R53 | R_200k_0402 | jetson-footprints:R_0402_1005Metric | C25764 | CR0402-FX-2003GLF
R55 | R_2k_0402 | jetson-footprints:R_0402_1005Metric | C4109 | CR0402-FX-2001GLF
R56 | R_0R_0402 | jetson-footprints:R_0402_1005Metric | C17168 | ERJ2GE0R00X
R57 | R_0R_0402 | jetson-footprints:R_0402_1005Metric | C17168 | ERJ2GE0R00X
R58 | R_0R_0402 | jetson-footprints:R_0402_1005Metric | C17168 | ERJ2GE0R00X
R59 | R_0R_0402 | jetson-footprints:R_0402_1005Metric | C17168 | ERJ2GE0R00X
R60 | R_0R_0402 | jetson-footprints:R_0402_1005Metric | C17168 | ERJ2GE0R00X
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
R133 | R_10k_0402 | jetson-footprints:R_0402_1005Metric | C25744 | CR0402-FX-1002GLF
R134 | R_10k_0402 | jetson-footprints:R_0402_1005Metric | C25744 | CR0402-FX-1002GLF
R135 | R_470R_0402 | jetson-footprints:R_0402_1005Metric | C25117 | CR0402-FX-4700GLF
R138 | R_10k_0402 | jetson-footprints:R_0402_1005Metric | C25744 | CR0402-FX-1002GLF
R140 | 4.7k | jetson-footprints:R_0402_1005Metric | C25900 | CR0402-FX-4701GLF
R141 | 4.7k | jetson-footprints:R_0402_1005Metric | C25900 | CR0402-FX-4701GLF
R142 | 4.7k | jetson-footprints:R_0402_1005Metric | C25900 | CR0402-FX-4701GLF
R143 | 4.7k | jetson-footprints:R_0402_1005Metric | C25900 | CR0402-FX-4701GLF
R144 | 100k | jetson-footprints:R_0402_1005Metric | C25741 | CR0402-FX-1003GLF
R145 | 100k | jetson-footprints:R_0402_1005Metric | C25741 | CR0402-FX-1003GLF
REC1 | SW_TL3340AF160QG_SMD | jetson-footprints:SW_TL3340AF160QG_SMD | C2886925 | TL3340AF160QG
RST1 | SW_TL3340AF160QG_SMD | jetson-footprints:SW_TL3340AF160QG_SMD | C2886925 | TL3340AF160QG
SP5 | Spacer_Drill3.7mm_H6mm_9774060151R | jetson-footprints:Spacer_Drill3.7mm_H6mm_9774060151R | C289551 | 9774060151R
SP6 | Spacer_Drill3.7mm_H6mm_9774060151R | jetson-footprints:Spacer_Drill3.7mm_H6mm_9774060151R | C289551 | 9774060151R
T1 | BSS138PW | jetson-footprints:SC70-3 | C84617 | BSS138PW
T2 | BSS138PW | jetson-footprints:SC70-3 | C84617 | BSS138PW
T3 | BSS138PW | jetson-footprints:SC70-3 | C84617 | BSS138PW
T4 | BSS138PW | jetson-footprints:SC70-3 | C84617 | BSS138PW
T5 | BSS138PW | jetson-footprints:SC70-3 | C84617 | BSS138PW
T6 | BSS138PW | jetson-footprints:SC70-3 | C84617 | BSS138PW
T8 | BSS138PW | jetson-footprints:SC70-3 | C84617 | BSS138PW
T9 | BSS138PW | jetson-footprints:SC70-3 | C84617 | BSS138PW
U2 | LM62440-Q1 | jetson-footprints:VQFN-HR-14_3.5x4mm | C524861 | LMQ62440BPPQRJRRQ1
U3 | SN74LXC1T45DBVR | jetson-footprints:SOT-23-6 | C2685415 | SN74LXC1T45DBVR
U4 | PCA9547_VQFN | jetson-footprints:VQFN-24-1EP_3.8x3.8x1.0mm_P0.5mm | C138804 | PCA9547BS,118
U6 | SIC477ED-T1-GE3 | jetson-footprints:SIC47XED-T1-GE3 | C516241 | SIC477ED-T1-GE3
U7 | MAX3051EKA | jetson-footprints:SOT-23-8 | C90741 | MAX3051EKA
U8 | 74LVC1G07_SOT-753 | jetson-footprints:SOT-753 | C7829 | 74LVC1G07GV,125
U10 | TPS7A0528PDBVR | jetson-footprints:SOT-23-5 | C194387 | TPS7A0528PDBVR
U11 | TLV75512PDBVR | jetson-footprints:SOT-23-5 | C485675 | TLV75512PDBVR
USER1 | LED_G_0603_LG_L29K-G2J1-24-Z | jetson-footprints:LED_0603_1608Metric_G | C72043 | LG L29K-G2J1-24-Z
USR1 | SW_TL3340AF160QG_SMD | jetson-footprints:SW_TL3340AF160QG_SMD | C2886925 | TL3340AF160QG
