CopperPilot/Jetson-AI-Cam-CopperPilot/3dmodels/Camera_Module_IMX219-M12.step

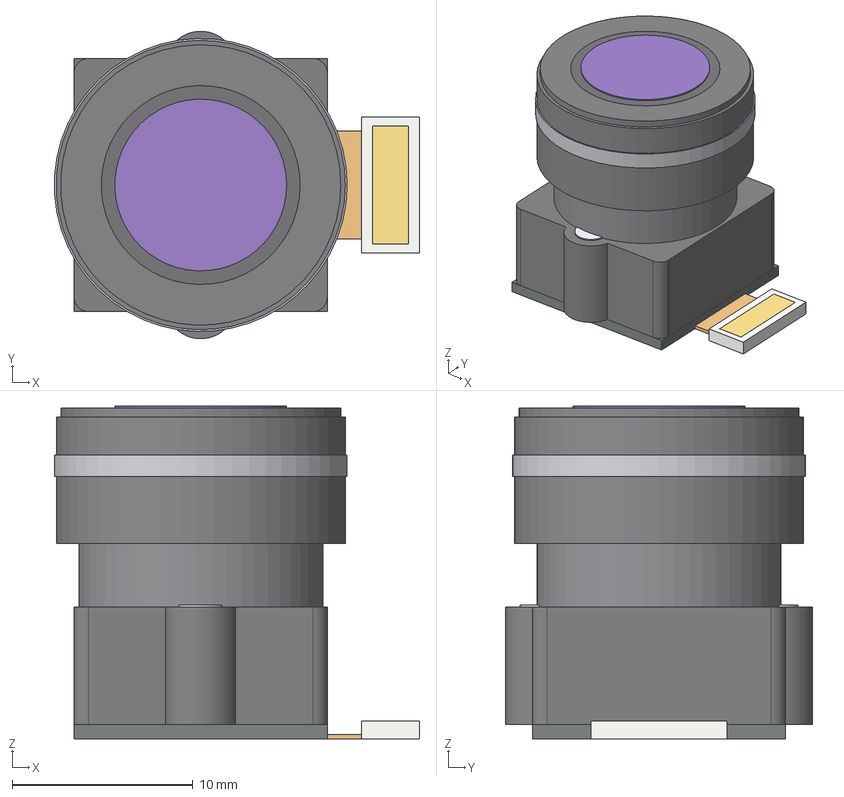
[picture p30: CAD file, 2026-10-06]
3dmodels/Camera_Module_IMX219-M12.step
20.2 x 17.0 x 18.4 mm
connector_nylon
connector_gold
flex_cable
sensor_pcb
lens_holder
mounting_screws
threaded_barrel
accent_ring
knurled_lens
inner_bezel
optical_glass
