CopperPilot/Jetson-AI-Cam-CopperPilot/3dmodels/MODULE_NVIDIA_JETSON-NANO.stl

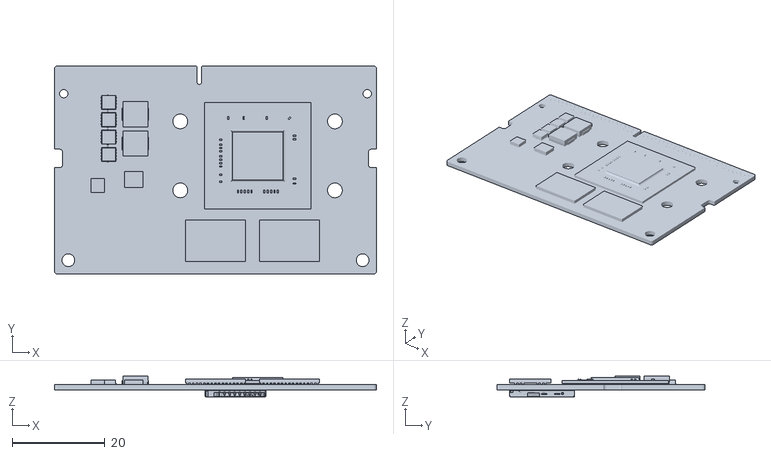
[picture p31: CAD file, 2026-10-02]
3dmodels/MODULE_NVIDIA_JETSON-NANO.stl
69.6 x 45.0 x 4.48
