CopperPilot/Jetson-AI-Cam-CopperPilot/3dmodels/test_m2.step

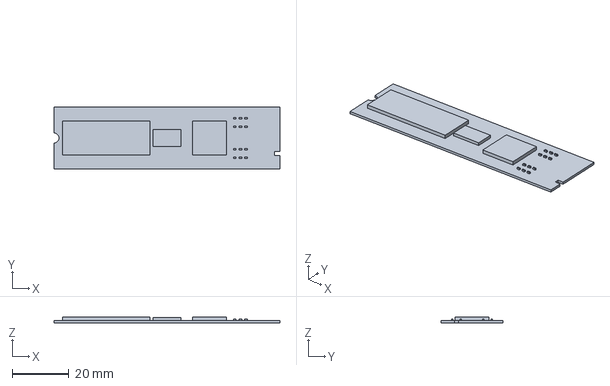
[picture p32: CAD file, 2026-10-02]
3dmodels/test_m2.step
80.0 x 22.0 x 2.00 mm
