CopperPilot/Jetson-AI-Cam-CopperPilot/3dmodels/9774040151.step

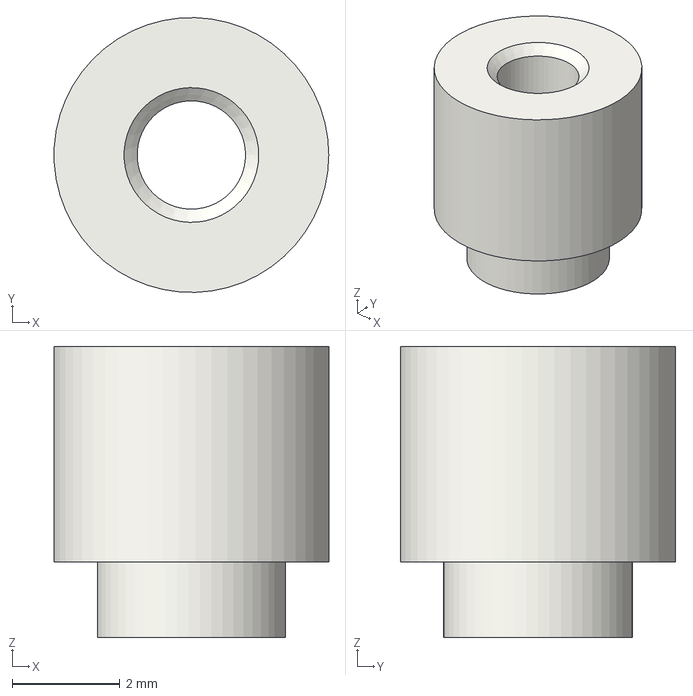
[picture p33: CAD file, 2026-10-02]
3dmodels/9774040151.step
5.10 x 5.10 x 5.40 mm
