CopperPilot/Jetson-AI-Cam-CopperPilot/review/renders/deep_dive/zones/zone5_usb_typec_debug_3D_Top.png

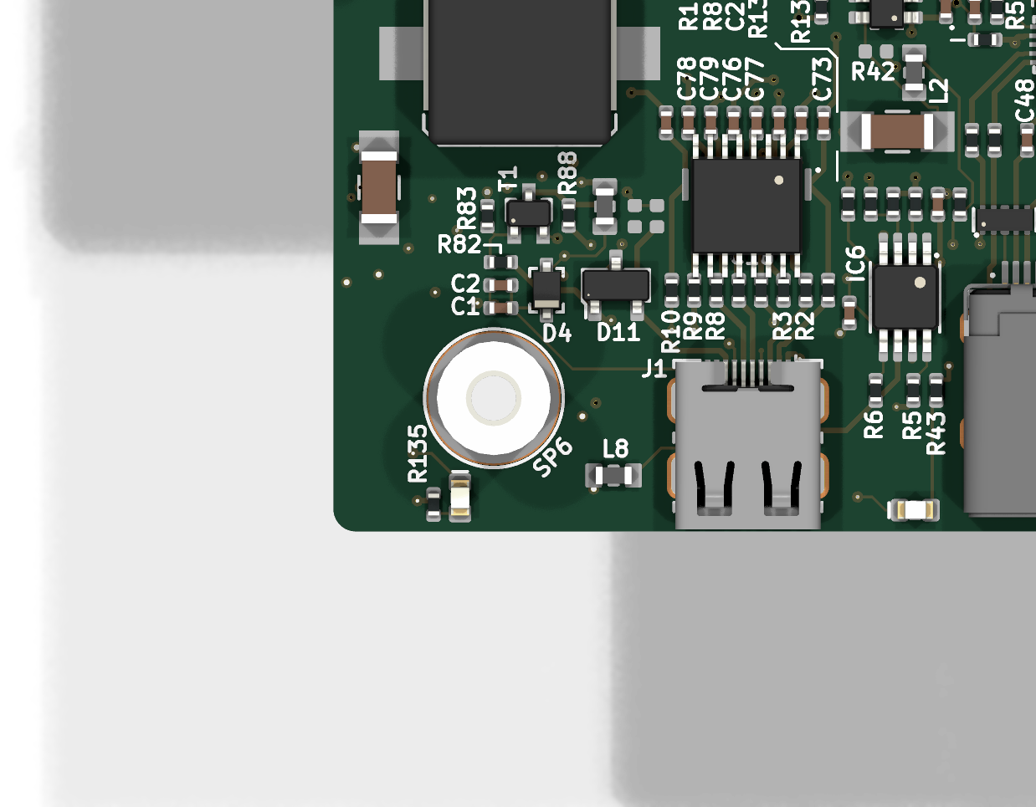
review/renders/deep_dive/zones/zone5_usb_typec_debug_3D_Top.png
