CopperPilot/Jetson-AI-Cam-CopperPilot/review/renders/deep_dive/zones/zone5_usb_typec_debug_F_Cu.png

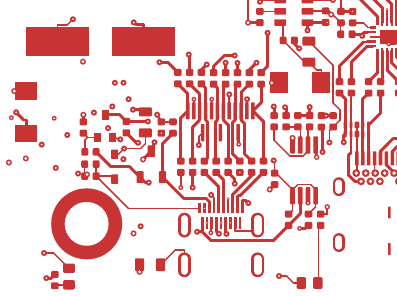
review/renders/deep_dive/zones/zone5_usb_typec_debug_F_Cu.png
