CopperPilot/Jetson-AI-Cam-CopperPilot/review/renders/deep_dive/zones/zone5_usb_typec_debug_In6_GND.png

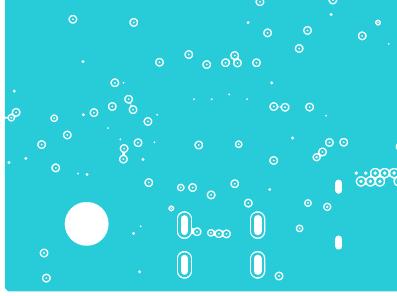
review/renders/deep_dive/zones/zone5_usb_typec_debug_In6_GND.png
