CopperPilot/Jetson-AI-Cam-CopperPilot/review/renders/issues/DFM-001/after.png

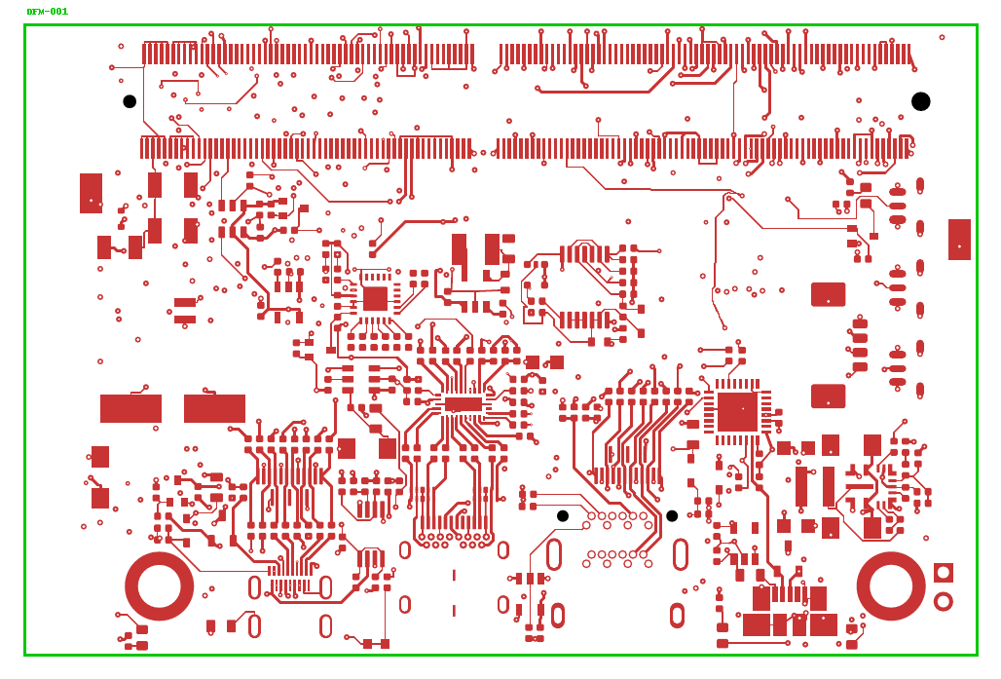
review/renders/issues/DFM-001/after.png
