CopperPilot/Jetson-AI-Cam-CopperPilot/review/renders/issues/PCB-002/diff.png

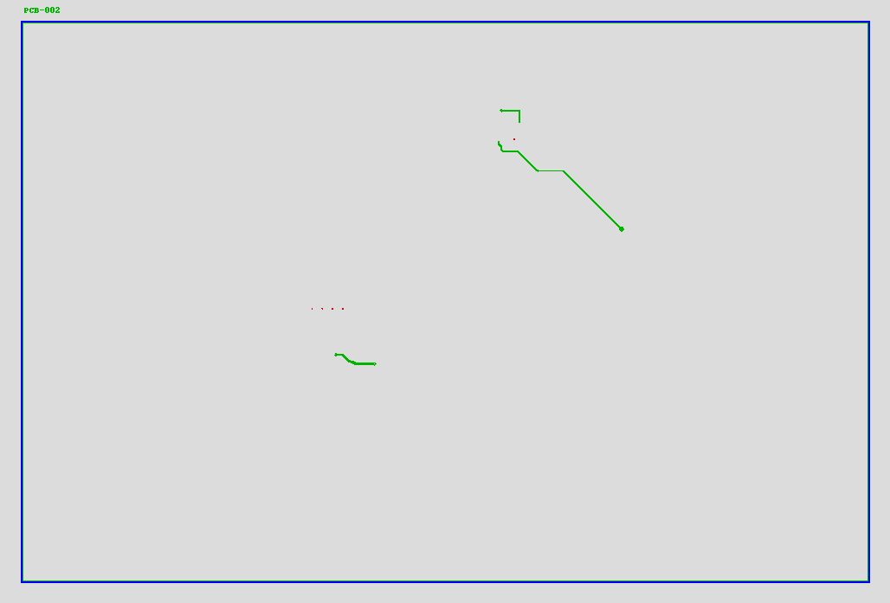
review/renders/issues/PCB-002/diff.png
