CopperPilot/Jetson-AI-Cam-CopperPilot/review/renders/issues/PCB-004/before.png

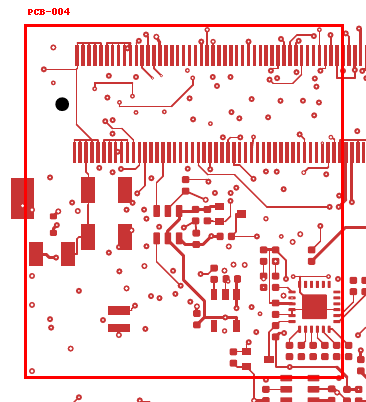
review/renders/issues/PCB-004/before.png
