CopperPilot/Jetson-AI-Cam-CopperPilot/review/renders/issues/SCH-002/diff.png

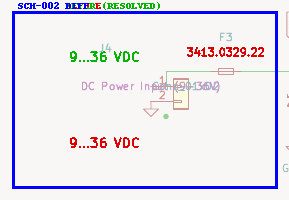
review/renders/issues/SCH-002/diff.png
