CopperPilot/Jetson-AI-Cam-CopperPilot/review/renders/issues/SCH-003/diff.png

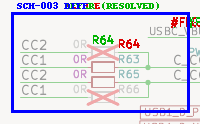
review/renders/issues/SCH-003/diff.png
