CopperPilot/Jetson-AI-Cam-CopperPilot/review/renders/issues/SCH-005/diff.png

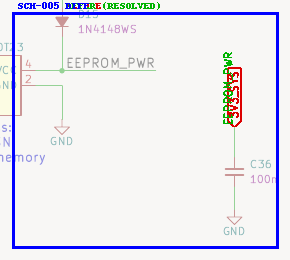
review/renders/issues/SCH-005/diff.png
