CopperPilot/Jetson-AI-Cam-CopperPilot/Jetson-AI-Cam-CopperPilot.kicad_pcb

## KiCad design Jetson-AI-Cam-CopperPilot.kicad_pcb (2026-10-24)

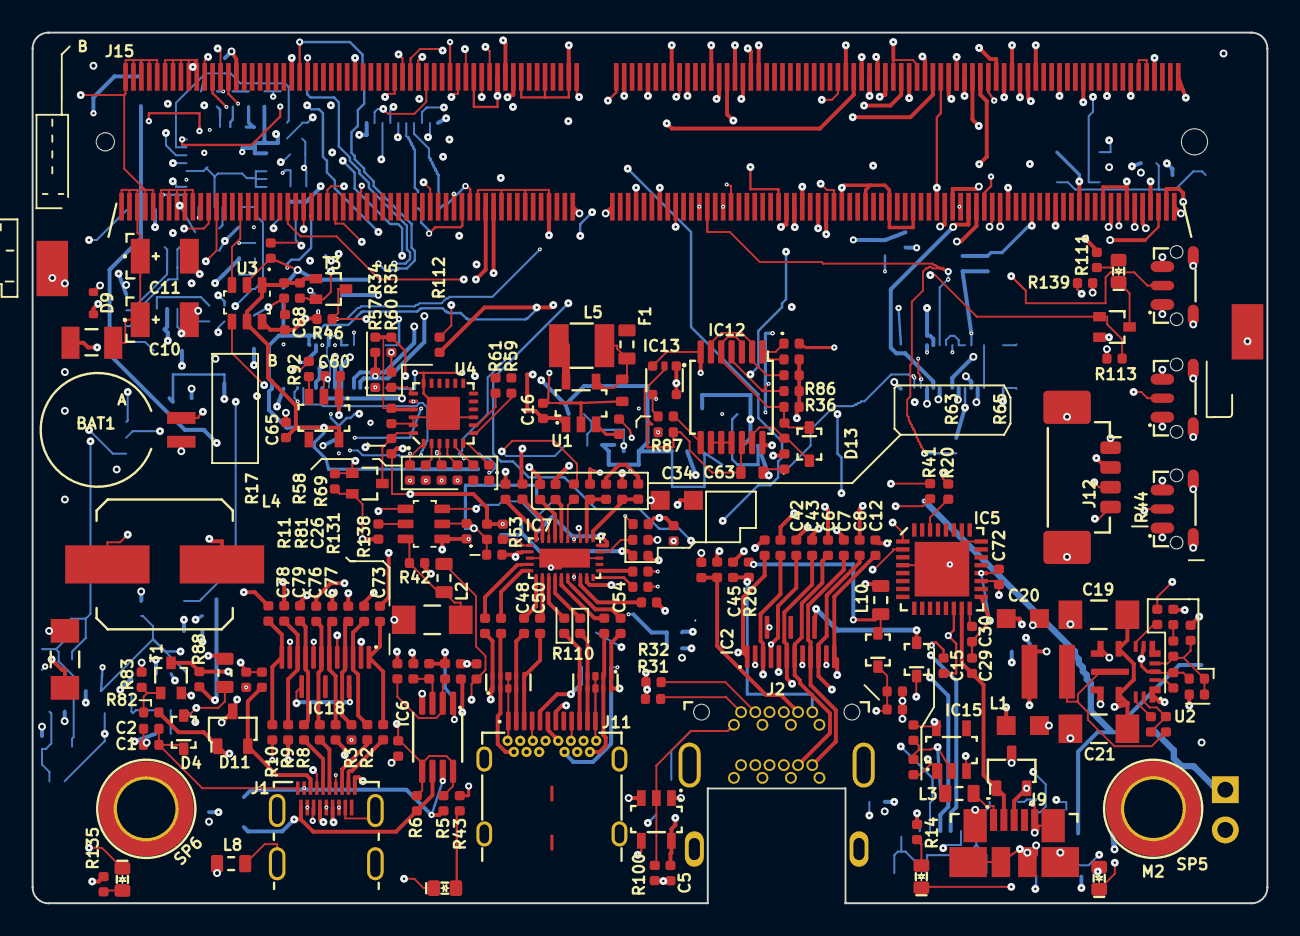
[picture p46: board Jetson-AI-Cam-CopperPilot.kicad_pcb from above]

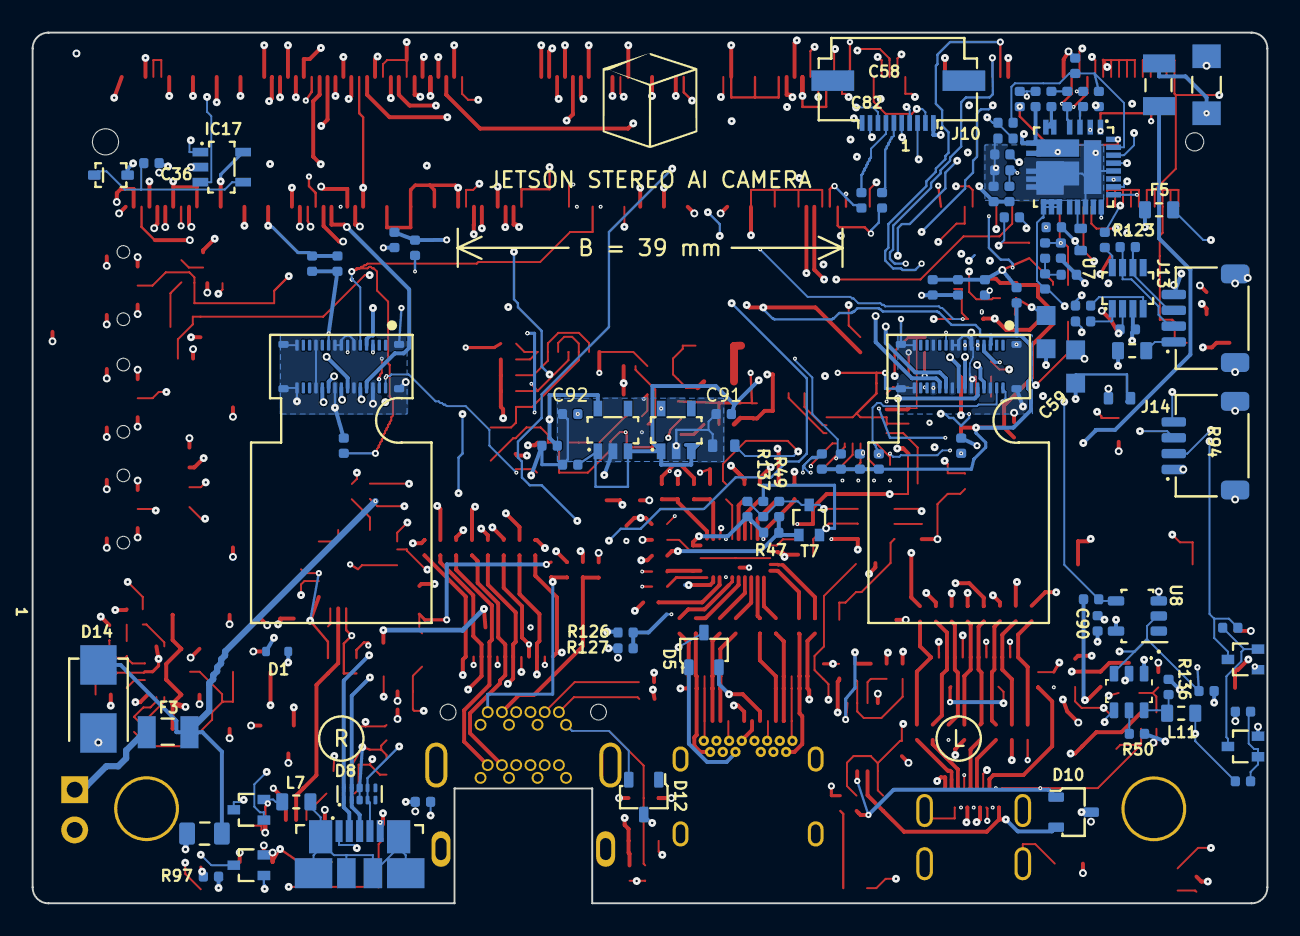
[picture p47: board Jetson-AI-Cam-CopperPilot.kicad_pcb from below]

Board: 8 copper layers, 78.0 x 55.0 mm, 305 parts (99 on the bottom side), 254 nets.

Parts:
BAT1: Battery_Holder_MS621FE-FL11E; MS621FE-FL11E
BOOT1: LED_G_0603_LG_L29K-G2J1-24-Z; LED_0603_1608Metric_G
C1, C2, C3, C4, C62: C_4u7_0402; C_0402_1005Metric
C5, C6, C7, C8, C9, C12, C13, C26, C27, C30, C33, C36, C39, C40, C42, C43, C44, C45, C48, C50, C53, C54, C57, C71, C72, C73, C74, C75, C76, C77, C78, C79, C80, C83, C86, C88, C89, C90, C95, C96, C97, C99, C100, C101, C103, C104: C_100n_0402; C_0402_1005Metric
C10, C11: C_Pol_330u_6.3V_KEMET-T520-B; C_Pol_EIA-B
C15, C29: C_47p_0402; C_0402_1005Metric
C16, C60, C67, C98, C102: C_2u2_0402; C_0402_1005Metric
C17, C19, C21, C22: C_10u_1206_50V; C_1206_3216Metric
C20, C34, C59, C64: C_47u_0805; C_0805_2012Metric
C23, C35, C63, C81: C_10u_0603; C_0603_1608Metric
C24: C_6p_0402; C_0402_1005Metric
C25: C_10u_0805; C_0805_2012Metric
C28: C_270p_25V_0402; C_0402_1005Metric
C31: C_100u_1206; C_1206_3216Metric
C32: C_10u_0402; C_0402_1005Metric
C41: C_47n_0402; C_0402_1005Metric
C56: C_100n_50V_0402; C_0402_1005Metric
C58: C_33n_0402; C_0402_1005Metric
C61, C82: C_1n2_50V_0402; C_0402_1005Metric
C65, C66, C84, C87: C_1u_0402; C_0402_1005Metric
C85: C_4u7_0603; C_0603_1608Metric
C91, C93: 1uF_0402; C_0402_1005Metric
C92, C94: 2.2uF_0402; C_0402_1005Metric
CAM_L: IMX219_30P; Camera_Module_IMX219-D160
CAM_R: IMX219_30P; Camera_Module_IMX219-D160
D1, D9: ESD5B5_0ST1G; SOD-523_NP
D2, D4: B0520W; D_SOD-323F
D3, D5, D10, D11, D12: PESD2USB5UV-TR; SOT-23-3
D6, D7, D8: TPD4E05U06QDQARQ1; USON-10_2.5x1mm_P0.5mm
D13, D15, D17: 1N4148WS; D_SOD-323F
D14: SMBJ33A; D_SMB
F1, F4, F5: F_1.25A_0603; F_0603_1608Metric
F3: F_12A_1206; F_1206_3216Metric
FB1, FB2: FB_10Z_10A_WE-MPSB_1206; FB_1206_3216Metric
FB3: FB_180Z_3.1A_WE-MPSB_0805; FB_0805_2012Metric
IC1, IC3: NCP380LSNAJAAT1G; SOT-23-6
IC2, IC18: TPD8S009DSMR; R-PDSO-N15
IC4, IC15: TPS7A0518P_SOT23-5; SOT-23-5
IC5: FT232R_QFN; QFN-32-1EP_5x5mm
IC6: PCA9517ADP; TSSOP-8_3x3mm_P0.65mm
IC7: HD3SS3220RNH; WQFN-30-1EP_4.6x2.6mm_P0.4mm
IC11: SN74LV1T125DBVR; SOT-23-5
IC12: 74HC00_TSSOP; TSSOP-14_4.4x5mm_P0.65mm
IC13: SN74LVC1G126_SC-70; SC-70-5
IC17: AT24CS01_SOT23; SOT-23-5
J1: HDMI-Micro-D_Molex_467561001; HDMI-Micro-D_Receptacle_Molex_467651001
J2: DisplayPort-Mini_TE_2129320-3; DisplayPort-Mini_Receptacle_TE_2129320-3
J4: Conn_01x02; PinHeader_1x02_P2.54mm_Vertical
J5, J9: USB-Micro-B_Molex_473460001; USB-Micro-B_Receptacle_Molex_473460001
J10: Conn_FFC_Molex_5051101097
J11: USB-C_WE_632723300011; USB-C_Receptacle_WE_632723300011
J12: Molex_PicoBlade_1x4_0533980471; Conn_Molex_PicoBlade_1x4_0533980471
J13, J14: JST_SH_1x4_SM04B-SRSS-TB-LF-SN; Conn_JST_SH_1x4_SM04B-SRSS-TB-LF-SN
J15: Bus_DDR4_SODIMM_CUSTOM_Jetson-Nano-H9.2mm-socket; TE_2309413
L1: L_2u2_8A_Coilcraft-XFL4020; L_Coilcraft-XFL4020
L2, L3, L7, L8, L9, L10, L11: FB_120Z_3A_Murata-BLM18SG_0603; FB_0603_1608Metric
L4: L_3u3_9.2A_Vishay-IHLP-3232DZ-01; L_Vishay-IHLP3232DZ
L5: L_2u2_1.6A_1210; L_1210_3225Metric
LED1, LED2: LED_G_0603_LG_L29K-G2J1-24-Z; LED_0603_1608Metric_G
M2: Jetson-Nano; Module_Jetson-Nano
PWR1: LED_G_0603_LG_L29K-G2J1-24-Z; LED_0603_1608Metric_G
R1, R2, R3, R4, R7, R8, R9, R10: R_5R6_0402; R_0402_1005Metric
R5, R6, R11, R34, R35, R37, R55, R73, R74, R81, R83, R88: R_2k_0402; R_0402_1005Metric
R12, R13, R15, R17, R19, R21, R42, R48, R49, R56, R57, R58, R59, R60, R61, R62, R63, R64, R65, R66, R68, R71, R76, R82, R92, R93, R98, R99, R101, R103, R104, R105, R106, R107, R108, R109, R110, R121, R124, R125, R126, R127, R129, R130, R136: R_0R_0402; R_0402_1005Metric
R14, R43, R97, R111, R135: R_470R_0402; R_0402_1005Metric
R16, R36, R45, R87: R_1k_0402; R_0402_1005Metric
R20, R41: R_22R_0402; R_0402_1005Metric
R26, R30, R47, R69, R91, R96, R100, R102, R112, R113, R118, R139: R_100k_0402; R_0402_1005Metric
R31, R32: R_1M_0402; R_0402_1005Metric
R39, R44, R46, R50, R54, R72, R85, R95, R120, R122, R131, R133, R134, R137, R138: R_10k_0402; R_0402_1005Metric
R51: R_909k_0402; R_0402_1005Metric
R53, R67, R84, R86: R_200k_0402; R_0402_1005Metric
R70: R_100R_0402; R_0402_1005Metric
R75: R_316k_0402; R_0402_1005Metric
R77: R_60k4_0402; R_0402_1005Metric
R89: R_3R3_0402; R_0402_1005Metric
R90: R_26k7_0402; R_0402_1005Metric
R94: R_8k66_0402; R_0402_1005Metric
R117: R_52k3_0402; R_0402_1005Metric
R119: R_44k2_0402; R_0402_1005Metric
R123: R_120R_0402; R_0402_1005Metric
R140, R141, R142, R143: 4.7k; R_0402_1005Metric
R144, R145: 100k; R_0402_1005Metric
REC1: SW_TL3340AF160QG_SMD
RST1: SW_TL3340AF160QG_SMD
SP5, SP6: Spacer_Drill3.7mm_H6mm_9774060151R
T1, T2, T3, T4, T5, T6, T7, T8, T9: BSS138PW; SC70-3
U1: LM3671MF-3.3_SOT; SOT-23-5
U2: LM62440-Q1; VQFN-HR-14_3.5x4mm
U3: SN74LXC1T45DBVR; SOT-23-6
U4: PCA9547_VQFN; VQFN-24-1EP_3.8x3.8x1.0mm_P0.5mm
U6: SIC477ED-T1-GE3; SIC47XED-T1-GE3
U7: MAX3051EKA; SOT-23-8
U8: 74LVC1G07_SOT-753; SOT-753
U10: TPS7A0528PDBVR; SOT-23-5
U11: TLV75512PDBVR; SOT-23-5
USER1: LED_G_0603_LG_L29K-G2J1-24-Z; LED_0603_1608Metric_G
USR1: SW_TL3340AF160QG_SMD

Connections:
1V2_CAM: C94.1, C96.1, C100.1, CAM_L.4, CAM_R.4, U11.5
1V8_DBG: C66.1, IC5.1 (VCCIO), IC15.5 (VOUT)
1V8_SYS: C5.1, C65.1, C86.1, C95.1, C99.1, CAM_L.3, CAM_R.3, IC4.5 (VOUT), IC6.1 (V_{CC(A)}), IC11.5 (VCC), R11.1, R81.1, R88.1, R95.1, R112.1, R133.1, R140.1, R141.1, R142.1, R143.1, T3.1 (G), U3.1 (VCCA), U3.5 (DIR)
2V8_CAM: C92.1, C97.1, C98.1, C101.1, C102.1, CAM_L.10, CAM_R.10, U10.5
3V3_SYS: C9.1, C13.1, C20.1, C24.1, C25.1, C26.1, C33.1, C91.1, C93.1, D1.2 (A), D15.2 (A), F4.1, F5.1, IC7.8 (VCC33), J10.1, L1.2, L10.1, R34.1, R35.1, R48.1, R53.1, R118.1, R122.1, U2.1 (BIAS), U4.21 (VCC), U7.3 (VCC), U10.1, U10.3, U11.1, U11.3
5V0_DBG: C67.1, C72.1, D17.1 (C), IC5.19 (VCC), IC15.1 (VIN), IC15.3 (EN), L3.1
5V0_SYS: C16.1, C32.1, C34.1, C59.1, C60.1, C64.1, C71.1, C81.1, C82.2, C83.1, C88.1, C90.1, D9.2 (A), D17.2 (A), FB2.1, IC1.1 (IN), IC2.13 (VCC), IC2.15 (VCC), IC3.1 (IN), IC4.1 (VIN), IC7.30 (VDD5), IC12.14 (VCC), IC13.1 (OE), IC13.5 (VCC), J12.2, L4.2, L9.1, R14.1, R16.1, R36.1, R42.1, R43.1, R46.1, R47.1, R54.1, R55.1, R67.1, R84.1, R86.1, R93.2, R97.1, R102.1, R111.1, R117.1, R126.1, R134.1, R135.1, R136.1, U1.1 (V_{IN}), U3.6 (VCCB), U8.5 (VCC)
#RECOVERY: J15.214 (~FORCE_RECOVERY), REC1.2
#RESET: J15.239 (~SYS_RESET), R39.1, R44.1, R92.1, R139.1, RST1.2, T2.1 (G)
#SHUTDOWN_REQ: IC12.4 (2A), J15.233 (~SHUTDOWN_REQ), R86.2
/CSI/CAM_I2C_SCL: J15.213 (CAM_I2C_SCL), R35.2, R60.1
/CSI/CAM_I2C_SDA: J15.215 (CAM_I2C_SDA), R34.2, R57.1
/Display/DP_CEC: J2.6 (CFG2), R32.1
/Display/DP_HPD: IC11.4 (Y), J15.88 (DP0_HPD)
/Display/DP_HPD_IN: D12.2, IC11.2 (A), J2.2 (HPD), R100.1
/Display/DP_MODE: J2.4 (CFG1), R31.1
/Display/EDP0_TX_N: C40.1, J15.39 (DP0_TXD0_N)
/Display/EDP0_TX_P: C39.1, J15.41 (DP0_TXD0_P)
/Display/EDP1_TX_N: C43.1, J15.45 (DP0_TXD1_N)
/Display/EDP1_TX_P: C42.1, J15.47 (DP0_TXD1_P)
/Display/EDP2_TX_N: C7.1, J15.51 (DP0_TXD2_N)
/Display/EDP2_TX_P: C6.1, J15.53 (DP0_TXD2_P)
/Display/EDP3_TX_N: C12.1, J15.57 (DP0_TXD3_N)
/Display/EDP3_TX_P: C8.1, J15.59 (DP0_TXD3_P)
/Display/EDP_AUX_N: C45.1, J15.90 (DP0_AUX_N)
/Display/EDP_AUX_P: C44.1, J15.92 (DP0_AUX_P)
/Display/EDP_C_AUX_C_N: C45.2, J2.18 (AUX-), R26.1
/Display/EDP_C_AUX_C_P: C44.2, J2.16 (AUX+), R30.1
/Display/ML_C_LANE0_N: C40.2, IC2.3 (D0-), J2.5 (TXD0-)
/Display/ML_C_LANE0_P: C39.2, IC2.1 (D0+), J2.3 (TXD0+)
/Display/ML_C_LANE1_N: C43.2, IC2.6 (D1-), J2.11 (TXD1-)
/Display/ML_C_LANE1_P: C42.2, IC2.4 (D1+), J2.9 (TXD1+)
/Display/ML_C_LANE2_N: C7.2, IC2.9 (D2-), J2.17 (TXD2-)
/Display/ML_C_LANE2_P: C6.2, IC2.7 (D2+), J2.15 (TXD2+)
/Display/ML_C_LANE3_N: C12.2, IC2.12 (D3-), J2.12 (TXD3-)
/Display/ML_C_LANE3_P: C8.2, IC2.10 (D3+), J2.10 (TXD3+)
/Display/TMDS_C1_CLK_N: C80.2, IC18.12 (D3-), R10.1
/Display/TMDS_C1_CLK_P: C78.2, IC18.10 (D3+), R9.1
/Display/TMDS_C1_D0_N: C79.2, IC18.9 (D2-), R8.1
/Display/TMDS_C1_D0_P: C76.2, IC18.7 (D2+), R7.1
/Display/TMDS_C1_D1_N: C77.2, IC18.6 (D1-), R4.1
/Display/TMDS_C1_D1_P: C75.2, IC18.4 (D1+), R3.1
/Display/TMDS_C1_D2_N: C74.2, IC18.3 (D0-), R2.1
/Display/TMDS_C1_D2_P: C73.2, IC18.1 (D0+), R1.1
/Display/TMDS_CEC_IN: D11.2, J1.15 (CEC), R37.1
/Display/TMDS_CLK_C_N: J1.14 (CK-), R10.2
/Display/TMDS_CLK_C_P: J1.12 (CK+), R9.2
/Display/TMDS_CLK_N: C80.1, J15.81 (DP1_TXD3_N)
/Display/TMDS_CLK_P: C78.1, J15.83 (DP1_TXD3_P)
/Display/TMDS_D0_C_N: J1.11 (D0-), R8.2
/Display/TMDS_D0_C_P: J1.9 (D0+), R7.2
/Display/TMDS_D0_N: C79.1, J15.75 (DP1_TXD2_N)
/Display/TMDS_D0_P: C76.1, J15.77 (DP1_TXD2_P)
/Display/TMDS_D1_C_N: J1.8 (D1-), R4.2
/Display/TMDS_D1_C_P: J1.6 (D1+), R3.2
/Display/TMDS_D1_N: C77.1, J15.69 (DP1_TXD1_N)
/Display/TMDS_D1_P: C75.1, J15.71 (DP1_TXD1_P)
/Display/TMDS_D2_C_N: J1.5 (D2-), R2.2
/Display/TMDS_D2_C_P: J1.3 (D2+), R1.2
/Display/TMDS_D2_N: C74.1, J15.63 (DP1_TXD0_N)
/Display/TMDS_D2_P: C73.1, J15.65 (DP1_TXD0_P)
/Display/TMDS_HPD_IN: D11.1, J1.1 (HPD/HEAC-), R82.2
/Display/TMDS_SCL: J15.100 (DP1_AUX_P), R98.1
/Display/TMDS_SCL_5V0: D10.1, IC6.7 (SCLB), J1.17 (SCL), R5.2
/Display/TMDS_SDA: J15.98 (DP1_AUX_N), R99.1
/Display/TMDS_SDA_5V0: D10.2, IC6.6 (SDAB), J1.18 (SDA), R6.2
/ID Serial/EEPROM_PWR: C36.1, D15.1 (C), IC17.4 (VCC)
/Interfaces/CANH: J13.2, R123.1, U7.7 (CANH)
/Interfaces/CANL: J13.3, R123.2, U7.6 (CANL)
/SoM/PMIC_BBAT: BAT1.1 (+), J15.235 (PMIC_BBAT)
/Supply/3V3_EN: R44.2, U2.7 (EN)
/Supply/3V3_FB: R45.2, R48.2, R118.2, R119.1, U2.4 (FB)
/Supply/3V3_R_C_BOOT: C89.2, R70.2, U2.14 (CBOOT)
/Supply/3V3_SW: C89.1, L1.1, U2.10 (SW)
/Supply/3V3_VCC: C87.1, U2.2 (VCC)
/Supply/3V3_VIN: C19.1, C21.1, FB3.2, U2.8 (VIN), U2.12 (VIN)
/Supply/5V_BOOT: C57.2, U6.4 (BOOT)
/Supply/5V_COMP: R75.1, U6.21 (NC)
/Supply/5V_EN: R91.1, U6.3 (EN)
/Supply/5V_FB: R117.2, R120.1, U6.22 (V_{FB})
/Supply/5V_FSW: R90.1, U6.24 (f_{SW})
/Supply/5V_ILIM: R76.2, R77.1, U6.25 (I_{LIMIT})
/Supply/5V_MODE: R74.1, U6.27 (MODE)
/Supply/5V_PHASE: R89.2, U6.5 (PHASE), U6.6 (PHASE)
/Supply/5V_SNS: C61.2, C82.1, R94.2
/Supply/5V_SS: C58.1, U6.19 (SS)
/Supply/5V_SW: L4.1, R94.1, U6.12 (SW), U6.13 (SW), U6.14 (SW)
/Supply/5V_VIN: C17.1, C22.1, C56.1, FB1.2, R91.2, U6.1 (V_{CIN}), U6.7 (V_{IN}), U6.8 (V_{IN})
/Supply/FAN_PMW_5V: J12.4, U3.4 (B)
/Supply/FAN_TACH_5V: J12.3, R46.2, T3.3 (D)
/Supply/Q: D13.1 (C), IC12.3 (~1Y), IC12.5 (2B), R36.2, R85.1
/Supply/QDEL: C63.1, D13.2 (A), IC12.12 (4A), IC12.13 (4B), IC13.2 (A), R85.2, R87.2
/Supply/VDD_5V_DCDC: C84.1, R76.1, R96.2, U6.26 (V_{DD})
/Supply/VDRV_5V_DCDC: C85.1, U6.16 (V_{DRV})
/Supply/\~PWR_SET: C41.1, IC12.1 (1A), R84.2
/USB/CC1: IC7.2 (CC1), R63.1, R66.1
/USB/CC2: IC7.1 (CC2), R64.1, R65.1
/USB/C_CC1: D5.2, J11.A5 (CC_{1}), R63.2, R64.2
/USB/C_CC2: D5.1, J11.B5 (CC_{2}), R65.2, R66.2
/USB/C_USBSS_RX1_N: D6.1, D6.10, J11.B10 (RX_{1}-), R104.2
/USB/C_USBSS_RX1_P: D6.2, D6.9, J11.B11 (RX_{1}+), R106.2
/USB/C_USBSS_RX2_N: D7.5, D7.6, J11.A10 (RX_{2}-), R109.2
/USB/C_USBSS_RX2_P: D7.4, D7.7, J11.A11 (RX_{2}+), R110.2
/USB/C_USBSS_RX6_N: IC7.10 (RX-), R108.2
/USB/C_USBSS_RX6_P: IC7.9 (RX+), R107.2
/USB/C_USBSS_TX1_N: C50.2, D6.5, D6.6, J11.A3 (TX_{1}-)
/USB/C_USBSS_TX1_P: C48.2, D6.4, D6.7, J11.A2 (TX_{1}+)
/USB/C_USBSS_TX2_N: C54.2, D7.1, D7.10, J11.B3 (TX_{2}-)
/USB/C_USBSS_TX2_P: C53.2, D7.2, D7.9, J11.B2 (TX_{2}+)
/USB/C_USBSS_TX6_N: IC7.7 (TX-), R105.2
/USB/C_USBSS_TX6_P: IC7.6 (TX+), R103.2
/USB/DBG_USB_D_N: C29.1, D3.1, IC5.15 (USBDM), J9.2 (D-)
/USB/DBG_USB_D_P: C15.1, D3.2, IC5.14 (USBDP), J9.3 (D+)
/USB/EN_MUX: IC7.12 (ENn_MUX), R56.2, R68.1
/USB/OTG_USB_ID: D8.4, D8.7, IC1.3 (~EN), J5.4 (ID), R134.2, T9.1 (G), U8.2 (A)
/USB/OTG_USB_VBUS: C62.1, J5.1 (VBUS), L11.2, R72.2
/USB/USBC_ADDR: IC7.22 (ADDR), R126.2, R127.1
/USB/USBC_ID: R47.2, R49.1, R68.2, T7.1 (G)
/USB/USBC_INTN: IC7.23 (INT_N/OUT3), R67.2
/USB/USBC_SCL: IC7.26 (SCL/OUT2), R125.2
/USB/USBC_SDA: IC7.25 (SDA/OUT1), R124.2
/USB/USBC_VBUS: C35.1, J11.A4 (VBUS), J11.A9 (VBUS), J11.B4 (VBUS), J11.B9 (VBUS), L2.2, R51.2, R131.1
/USB/USBSS_RX1_N: IC7.14 (RX1-), R104.1
/USB/USBSS_RX1_P: IC7.15 (RX1+), R106.1
/USB/USBSS_RX2_N: IC7.18 (RX2-), R109.1
/USB/USBSS_RX2_P: IC7.19 (RX2+), R110.1
/USB/USBSS_TX1_N: C48.1, IC7.16 (TX1-)
/USB/USBSS_TX1_P: C50.1, IC7.17 (TX1+)
/USB/USBSS_TX2_N: C53.1, IC7.20 (TX2-)
/USB/USBSS_TX2_P: C54.1, IC7.21 (TX2+)
/USB/USB_DBG_VBUS: J9.1 (VBUS), L3.2
/USB/~OTG_USB_FAULT: IC1.4 (~FAULT), LED2.1 (C)
CAM0_MCLK: CAM_L.7, J15.116 (CAM0_MCLK)
CAM0_PWDN: CAM_L.5, J15.114 (CAM0_PWDN), R144.1
CAM0_SCL: CAM_L.29, R15.2, R140.2
CAM0_SDA: CAM_L.30, R13.2, R141.2
CAM1_MCLK: CAM_R.7, J15.122 (CAM1_MCLK)
CAM1_PWDN: CAM_R.5, J15.120 (CAM1_PWDN), R145.1
CAM1_SCL: CAM_R.29, R21.2, R142.2
CAM1_SDA: CAM_R.30, R17.2, R143.2
CAN_RXD: J15.143 ((CAN_RX)RSVD), R101.1
CAN_TXD: J15.145 ((CAN_TX)RSVD), R71.1
CSI_A_CLK_N: CAM_L.26, J15.10 (CSI0_CLK_N)
CSI_A_CLK_P: CAM_L.27, J15.12 (CSI0_CLK_P)
CSI_A_D0_N: CAM_L.23, J15.4 (CSI0_D0_N)
CSI_A_D0_P: CAM_L.24, J15.6 (CSI0_D0_P)
CSI_A_D1_N: CAM_L.20, J15.16 (CSI0_D1_N)
CSI_A_D1_P: CAM_L.21, J15.18 (CSI0_D1_P)
CSI_C_CLK_N: CAM_R.26, J15.52 (CSI4_CLK_N)
CSI_C_CLK_P: CAM_R.27, J15.54 (CSI4_CLK_P)
CSI_C_D0_N: CAM_R.23, J15.46 (CSI4_D0_N)
CSI_C_D0_P: CAM_R.24, J15.48 (CSI4_D0_P)
CSI_C_D1_N: CAM_R.20, J15.58 (CSI4_D1_N)
CSI_C_D1_P: CAM_R.21, J15.60 (CSI4_D1_P)
DP_PWR: D2.2 (A), L10.2, R26.2
FAN_PWM: J15.230 (GPIO14), U3.3 (A)
FAN_TACH: J15.208 (GPIO08), R95.2, T3.2 (S)
GEN0_SCL: IC17.1 (SCL), J15.185 (I2C0_SCL), R124.1
GEN0_SDA: IC17.3 (SDA), J15.187 (I2C0_SDA), R125.1
GND: BAT1.2 (-), C1.2, C2.2, C3.2, C4.2, C5.2, C9.2, C10.2, C11.2, C13.2, C15.2, C16.2, C17.2, C19.2, C20.2, C21.2, C22.2, C23.2, C25.2, C26.2, C27.2, C28.2, C29.2, C30.2, C31.2, C32.2, C33.2, C34.2, C35.2, C36.2, C41.2, C56.2, C58.2, C59.2, C60.2, C62.2, C63.2, C64.2, C65.2, C66.2, C67.2, C71.2, C72.2, C81.2, C83.2, C84.2, C85.2, C86.2, C87.2, C88.2, C90.2, C91.2, C92.2, C93.2, C94.2, C95.2, C96.2, C97.2, C98.2, C99.2, C100.2, C101.2, C102.2, CAM_L.6, CAM_L.8, CAM_L.9, CAM_L.12, CAM_L.15, CAM_L.16, CAM_L.19, CAM_L.22, CAM_L.25, CAM_L.28, CAM_L.SH, CAM_R.6, CAM_R.8, CAM_R.9, CAM_R.12, CAM_R.15, CAM_R.16, CAM_R.19, CAM_R.22, CAM_R.25, CAM_R.28, CAM_R.SH, D1.1 (C), D3.3, D5.3, D6.3, D6.8, D7.3, D7.8, D8.3, D8.8, D9.1 (C), D10.3, D11.3, D12.3, D14.2 (A), IC1.2 (GND), IC2.2 (GND), IC2.5 (GND), IC2.8 (GND), IC2.11 (GND), IC3.2 (GND), IC4.2 (GND), IC5.4 (GND), IC5.17 (GND), IC5.20 (GND), IC5.24 (AGND), IC5.26 (TEST), IC5.33 (EP), IC6.4 (GND), IC7.13 (GND), IC7.28 (GND), IC7.31 (GND), IC11.1 (~OE), IC11.3 (GND), IC12.7 (GND), IC13.3 (GND), IC15.2 (GND), IC17.2 (GND), IC17.5 (WP), IC18.2 (GND), IC18.5 (GND), IC18.8 (GND), IC18.11 (GND), J2.1 (GND), J2.7 (GND), J2.8 (GND), J2.13 (GND), J2.14 (GND), J2.19 (GND), J2.SH, J4.2, J5.5 (GND), J9.5 (GND), J9.SH (SHIELD), J10.10, J11.A1 (GND), J11.A12 (GND), J11.B1 (GND), J11.B12 (GND), J11.SH, J12.1, J12.MP1, J12.MP2, J13.4, J13.MP, J14.1, J14.MP, J15.1 (GND), J15.2 (GND), J15.7 (GND), J15.8 (GND), J15.13 (GND), J15.14 (GND), J15.19 (GND), J15.20 (GND), J15.25 (GND), J15.26 (GND), J15.31 (GND), J15.32 (GND), J15.37 (GND), J15.38 (GND), J15.43 (GND), J15.44 (GND), J15.49 (GND), J15.50 (GND), J15.55 (GND), J15.56 (GND), J15.61 (GND), J15.62 (GND), J15.67 (GND), J15.68 (GND), J15.73 (GND), J15.74 (GND), J15.79 (GND), J15.80 (GND), J15.85 (GND), J15.86 (GND), J15.102 (GND), J15.107 (GND), J15.113 (GND), J15.119 (GND), J15.125 (GND), J15.129 (GND), J15.132 (GND), J15.135 (GND), J15.138 (GND), J15.141 (GND), J15.144 (GND), J15.146 (GND), J15.147 (GND), J15.152 (GND), J15.153 (GND), J15.158 (GND), J15.159 (GND), J15.164 (GND), J15.165 (GND), J15.170 (GND), J15.171 (GND), J15.176 (GND), J15.177 (GND), J15.200 (GND), J15.201 (GND), J15.217 (GND), J15.231 (GND), J15.241 (GND), J15.242 (GND), J15.243 (GND), J15.244 (GND), J15.245 (GND), J15.246 (GND), J15.247 (GND), J15.248 (GND), J15.249 (GND), J15.250 (GND), J15.261 (MNT), J15.262 (MNT), L7.2, L8.1, R12.2, R30.2, R31.2, R32.2, R37.2, R50.2, R56.1, R62.1, R69.2, R73.2, R74.2, R77.2, R83.2, R90.2, R100.2, R113.1, R119.2, R120.2, R121.2, R127.2, R131.2, R137.2, R138.2, R139.2, R144.2, R145.2, REC1.1, REC1.3, REC1.SH, RST1.1, RST1.3, RST1.SH, SP5.1, SP6.1, T1.2 (S), T2.2 (S), T4.2 (S), T5.2 (S), T6.2 (S), T7.2 (S), T8.2 (S), U1.2 (GND), U2.3 (AGND), U2.6 (MODE), U2.9 (PGND), U2.11 (PGND), U3.2 (GND), U4.9 (GND), U4.18 (A2), U4.22 (A0), U4.23 (A1), U4.25 (EP), U6.9 (PGND), U6.10 (PGND), U6.11 (PGND), U6.17 (PGND), U6.23 (AGND), U6.28 (AGND), U7.2 (GND), U8.3 (GND), U10.2, U11.2, USR1.1, USR1.3, USR1.SH
HDMI_PWR: C27.1, D4.2 (A), IC6.5 (EN), IC6.8 (V_{CC(B)}), IC18.13 (VCC), IC18.15 (VCC), L9.2, R5.1, R6.1
HDMI_SHIELD: J1.4 (D2S), J1.7 (D1S), J1.10 (D0S), J1.13 (CKS), J1.SH, L8.2
I2C1_SCL: J14.4, J15.189 (I2C1_SCL)
I2C1_SDA: J14.3, J15.191 (I2C1_SDA)
I2C_MUX_RESET: J15.127 (GPIO04), R69.1, T8.1 (G)
unnamed: BOOT1.2 (A), R14.2
unnamed: BOOT1.1 (C), T2.3 (D)
unnamed: C24.2, R45.1
unnamed: C28.1, R75.2
unnamed: C57.1, R89.1
unnamed: C103.2, J10.6
unnamed: C104.2, J10.7
unnamed: C3.1, C4.1, D2.1 (C), J2.20 (DP_PWR)
unnamed: C1.1, C2.1, D4.1 (C), J1.19 (+5V)
unnamed: F4.2, J13.1
unnamed: F5.2, J14.2
unnamed: IC1.5 (ILIM), R50.1
unnamed: IC1.6 (OUT), L11.1, R136.2
unnamed: IC3.5 (ILIM), R138.1
unnamed: C31.1, IC3.6 (OUT), L2.1, R42.2
unnamed: IC3.3 (~EN), R49.2, R102.2, R137.1, T7.3 (D)
unnamed: IC3.4 (~FAULT), LED1.1 (C)
unnamed: IC4.3 (EN), R92.2
unnamed: C30.1, IC5.16 (3V3OUT)
unnamed: IC5.2 (RXD), R41.2
unnamed: IC5.30 (TXD), R20.2
unnamed: IC6.2 (SCLA), R81.2, R98.2
unnamed: IC6.3 (SDAA), R11.2, R99.2
unnamed: IC7.3 (CURRENT_MODE), R54.2
unnamed: IC7.11 (DIR), R53.2
unnamed: IC7.29 (ENn_CC), R62.2
unnamed: IC7.4 (PORT), R55.2
unnamed: IC7.5 (VBUS_DET), R51.1
unnamed: IC12.2 (1B), IC12.6 (~2Y), R16.2
unnamed: IC12.9 (3A), IC12.10 (3B), IC12.11 (~4Y)
unnamed: IC12.8 (~3Y), R130.2
unnamed: J1.16 (GND), R12.1
unnamed: F3.1, J4.1
unnamed: J5.SH (SHIELD), L7.1
unnamed: LED1.2 (A), R43.2
unnamed: LED2.2 (A), R135.2
unnamed: PWR1.2 (A), R97.2
unnamed: PWR1.1 (C), T4.3 (D)
unnamed: R82.1, R83.1, T1.1 (G)
unnamed: T5.3 (D), USER1.1 (C)
unnamed: R129.2, T6.3 (D), T9.2 (S)
unnamed: R72.1, R73.1, T6.1 (G)
unnamed: R122.2, T8.3 (D), U4.24 (~RESET)
unnamed: R39.2, U1.3 (EN)
unnamed: C23.1, F1.1, L5.2, U1.4 (FB)
unnamed: L5.1, U1.5 (SW)
unnamed: R70.1, U2.13 (RBOOT)
unnamed: R15.1, U4.2 (SC0)
unnamed: R21.1, U4.4 (SC1)
unnamed: R58.1, U4.6 (SC2)
unnamed: R61.1, U4.8 (SC3)
unnamed: R60.2, U4.19 (SCL)
unnamed: R13.1, U4.1 (SD0)
unnamed: R17.1, U4.3 (SD1)
unnamed: R19.1, U4.5 (SD2)
unnamed: R59.1, U4.7 (SD3)
unnamed: R57.2, U4.20 (SDA)
unnamed: C61.1, R93.1, U6.20 (V_{SNS})
unnamed: R121.1, U7.8 (RH)
unnamed: R101.2, U7.4 (RXD)
unnamed: R71.2, U7.1 (TXD)
unnamed: R111.2, USER1.2 (A)
OTG_USB_D_N: D8.1, D8.10, J5.2 (D-), J15.109 (USB0_D_N)
OTG_USB_D_P: D8.2, D8.9, J5.3 (D+), J15.111 (USB0_D_P)
PCIE1_CLKREQ: J10.3, J15.182 (PCIE1_CLKREQ)
PCIE1_CLK_N: J10.5, J15.173 (PCIE1_CLK_N)
PCIE1_CLK_P: J10.4, J15.175 (PCIE1_CLK_P)
PCIE1_RST: J10.2, J15.183 (PCIE1_RST)
PCIE1_RX0_N: J10.9, J15.167 (PCIE1_RX0_N)
PCIE1_RX0_P: J10.8, J15.169 (PCIE1_RX0_P)
PCIE1_TX0_N: C104.1, J15.172 (PCIE1_TX0_N)
PCIE1_TX0_P: C103.1, J15.174 (PCIE1_TX0_P)
PWR_EN: IC13.4 (Y), J15.237 (POWER_EN), R130.1
PWR_GOOD: R87.1, R96.1, T4.1 (G), U6.2 (P_{GOOD})
TMDS_HPD: J15.96 (DP1_HPD), R88.2, T1.3 (D)
UART1_RX: J15.238 (UART2_RXD), R20.1
UART1_TX: J15.236 (UART2_TXD), R41.1
USB1_D_N: J11.A7 (D_{A}-), J11.B7 (D_{B}-), J15.115 (USB1_D_N)
USB1_D_P: J11.A6 (D_{A}+), J11.B6 (D_{B}+), J15.117 (USB1_D_P)
USBSS_RX6_N: J15.161 (USBSS_RX_N), R108.1
USBSS_RX6_P: J15.163 (USBSS_RX_P), R107.1
USBSS_TX6_N: J15.166 (USBSS_TX_N), R105.1
USBSS_TX6_P: J15.168 (USBSS_TX_P), R103.1
USR_BUTTON: J15.218 (GPIO12), R112.2, USR1.2
USR_LED: J15.206 (GPIO07), R113.2, T5.1 (G)
VDD_MOD: C10.1, C11.1, FB2.2, J15.251 (VDD_IN), J15.252 (VDD_IN), J15.253 (VDD_IN), J15.254 (VDD_IN), J15.255 (VDD_IN), J15.256 (VDD_IN), J15.257 (VDD_IN), J15.258 (VDD_IN), J15.259 (VDD_IN), J15.260 (VDD_IN)
VIN: D14.1 (C), F3.2, FB1.1, FB3.1
~OTG_USB_ID_DET: J15.128 (GPIO05), R133.2, U8.4 (Y)
~OTG_USB_VBUS_DET: J15.87 (GPIO00), R129.1, T9.3 (D)
