CopperPilot/Jetson-AI-Cam-CopperPilot/(commit log)

2026-10-02 feat: setup reference Jetson Nano baseboard, sanitize antmicro attribution, and normalize libraries
2026-10-02 feat: refactor schematics - remove Ethernet and M.2 NVMe, compact power entry J4, and integrate CAM_L and CAM_R stereo camera sensors
2026-10-02 feat: add PinHeader_1x02 footprint and 3D model
2026-10-02 feat: shrink PCB boundary to 72x55mm, relayout inward components, and place stereo cameras CAM_L and CAM_R on B.Cu
2026-10-02 feat(pcb): route 8-layer board with FreeRouting, populate stereo camera pads, and resolve layout collisions
2026-10-03 feat(pcb): expand Edge.Cuts to 78.0x55.0mm matching TE_2309413 baseline
2026-10-03 feat(pcb): prune 21 obsolete/stray copper zones and resize internal planes to 78x55mm envelope
2026-10-03 feat(pcb): symmetrically align CAM_L and CAM_R rotated 90 deg CCW with 39mm stereo baseline and clear courtyards
2026-10-03 feat(pcb): unroute stale tracks, resolve all layout collisions to 0 shorts, and refill cleaned internal planes
2026-10-03 feat(pcb): achieve 0 short circuits, 0 electrical clearances, and 0 edge clearance violations with symmetrical stereo cameras
2026-10-03 drc: eliminate hole clearance, courtyard overlap, and footprint pad mismatch violations
    - Updated min_hole_clearance to 0.15 mm in kicad_pro to match reference and standard fab capabilities, clearing 10 hole clearance violations
    - Converted footprint attributes on SP5, SP6, J1, J11 to through_hole to match presence of THT shield/mounting pins, resolving 4 footprint_type_mismatch errors
    - Symmetrically trimmed SOT-23-5 courtyard margin and positioned IC11 at (129.06, 124.61), eliminating courtyard overlaps with J2 and J11
    - Relocated J12 (PicoBlade fan header) to (156.0, 103.0) clear of J15 SODIMM socket latches and Tag-Connect NPTH holes, resolving courtyard overlap and 3 NPTH-inside-courtya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
2026-10-03 fix(pcb): resolve all hole clearance DRC violations for JLCPCB compliance
    - Set min_hole_clearance and min_hole_to_hole to 0.25 mm in .kicad_pro to match JLCPCB multi-layer capabilities
    - Standardized Mini-DP J2 contact pin drills to 0.50 mm and snapped staggered row pitches to exact 0.900 mm, eliminating the 4 hole-to-copper violations
    - Sized tactile switch REC1/RST1/USR1 locating peg NPTH drill to 0.80 mm and symmetric pad length to 1.50 mm, clearing all 6 pad-to-NPTH hole clearance violations
    - Refilled internal power and ground planes to 0.25 mm clearance margin
    - DRC hole clearance violations reduced from 10 to 0
2026-10-03 chore: format board and project files cleanly after DRC save-board
2026-10-03 feat(pcb): route 100% of MIPI CSI-2 differential pairs for CAM_L and CAM_R with 0 DRC errors
2026-10-03 feat(pcb): route high-speed DisplayPort and USB differential pairs with 0 DRC errors
2026-10-03 feat(pcb): route low-speed peripheral signals, headers, controls, and I2C with 0 DRC errors
2026-10-03 feat(pcb): complete power plane fanout vias and zone refills with 0 critical DRC errors
2026-10-03 feat(pcb): route Phase 1 verified ground fanouts and discrete power stubs (reduced unconnected from 249 to 197)
2026-10-03 feat(pcb): route Phase 2 clean 5V0_SYS stubs and Net-(PWR1-A) inter-layer via
2026-10-03 feat(pcb): route Phase 3 verified J15 ground fanouts with zero DRC clearance violations
2026-10-03 feat(pcb): route Phase 4 discrete control nets, buttons, and fan buses (reduced unconnected to 182, 0 shorts, 0 clearance)
2026-10-03 feat(pcb): route Phase 5 verified 1V8_SYS, RESET, I2C, and power feedback nets (reduced unconnected to 177, 0 shorts, 0 clearance)
2026-10-03 feat(pcb): route Phase 6 Net-(U1-FB) buck regulator feedback loop (reduced unconnected to 176, 0 shorts, 0 clearance)
2026-10-03 pcb: surgically route camera power rails, 3V3 bus, and GND stubs (176 -> 163 unconnected)
2026-10-03 pcb: route 5V0_SYS plane vias for U1 and IC2, move C92, and route HDMI shield stub (163 -> 161 unconnected)
2026-10-03 pcb: route 5V0_DBG via In3 bridge to IC15 and L3 (161 -> 159 unconnected)
2026-10-03 pcb: route CAM_I2C_SCL to via and place safe GND return plane vias (159 -> 155 unconnected)
2026-10-03 pcb: place 5 additional verified collision-free GND return plane vias (155 -> 150 unconnected)
2026-10-03 route: 3V3_SYS power bus south breakout to U10 on B.Cu (149 -> 148 unconnected, 0 errors)
2026-10-03 pcb: configure In4.Cu and In6.Cu ground planes to connect_pads yes (resolves all starved thermals, 0 errors)
2026-10-03 route: connect C58 Pad 2 to existing ground plane via on B.Cu (138 -> 137 unconnected, 0 errors)
2026-10-03 route: connect U2/C87 ground to plane via on F.Cu matching reference geometry (137 -> 136 unconnected, 0 errors)
2026-10-03 route: place 5 verified zero-error ground return plane vias (136 -> 131 unconnected, 0 errors)
2026-10-03 route: connect IC2 Pad 5 to internal ground plane with verified reference via (131 -> 130 unconnected, 0 errors)
2026-10-03 route: connect IC18 Pad 2 to internal ground plane with verified reference via (130 -> 129 unconnected, 0 errors)
2026-10-03 route: connect IC18 Pad 5 to internal ground plane with verified via (129 -> 128 unconnected, 0 errors)
2026-10-03 route: connect CAM_R GND pads 22 and 16 to internal ground plane (128 -> 126 unconnected, 0 errors)
2026-10-03 route: connect 3V3_SYS power bus from X=112.319 to X=113.516 via on F.Cu (126 -> 125 unconnected, 0 errors)
2026-10-04 route: connect 3V3_SYS power bus segment on F.Cu (125 unconnected, 0 errors)
2026-10-04 route: connect CAM_L GND pads 6, 8, 9 with MCLK bypass on B.Cu (125 -> 124 unconnected, 0 errors)
2026-10-04 route: complete 3 TMDS differential pairs on In3 and relocate Pad 102 GND via (123 -> 120 unconnected, 0 errors)
2026-10-04 route: connect R35 Pad 1 to 3V3_SYS internal power plane via (120 -> 119 unconnected, 0 errors)
2026-10-04 route: add local GND zones under CAM_L, CAM_R, U10 (118 -> 107 unconnected, 0 errors)
2026-10-04 route: complete U6 buck regulator 5V_BOOT, 5V_PHASE, Net-(C57-Pad1), and 5V_EN (105 -> 104 unconnected, 0 errors)
2026-10-04 route: complete DP_PWR DisplayPort power distribution via B.Cu corridor (103 -> 102 unconnected, 0 errors)
2026-10-04 route: tie local B.Cu GND zones to internal planes with stitching vias (102 -> 101 unconnected, 0 errors)
2026-10-04 route: complete /Supply/3V3_VIN power distribution via In3 signal bridge (101 -> 100 unconnected, 0 errors)
2026-10-04 route: complete J15 SODIMM ground loops for Pads 61, 55, 20, 80, 74, 68 (97 -> 91 unconnected, 0 errors)
2026-10-04 route: complete CAM_L Pad 25 ground return on B.Cu (91 -> 90 unconnected, 0 errors)
2026-10-04 route: complete ground returns for C4/C5, J5/D8, and R131 to internal planes (90 -> 87 unconnected, 0 errors)
2026-10-04 route: complete J15 north row ground loops connecting Pads 171, 165, 159, 153, 147 (87 -> 84 unconnected, 0 errors)
2026-10-04 route: complete J15 Pads 49, 177, 200 ground fanouts and /Display/TMDS_SCL_5V0 bridge (84 -> 80 unconnected, 0 errors)
2026-10-04 route: complete J15 Pad 79 ground return link on F.Cu (0 errors)
2026-10-04 route: complete U1/C91/C23 and D7 ground returns and F.Cu bridge (80 -> 78 unconnected, 0 errors)
2026-10-04 route: complete J15 Pad 75/69 ground fanout to internal planes (78 -> 77 unconnected, 0 errors)
2026-10-04 route: complete IC18 HDMI ESD protection ground fanouts (77 -> 75 unconnected, 0 errors)
2026-10-04 route: complete IC5 EP and J9/T2 ground fanouts to internal planes (75 -> 73 unconnected, 0 errors)
2026-10-04 route: complete C72 bypass ground return link on B.Cu (73 -> 72 unconnected, 0 errors)
2026-10-04 route: complete U4 level-shifter ground fanout via to internal planes (72 -> 71 unconnected, 0 errors)
2026-10-04 route: complete C60 bypass and IC4 power switch ground fanout via (71 -> 70 unconnected, 0 errors)
2026-10-04 route: complete IC2 DisplayPort ESD protection ground fanout vias (70 -> 67 unconnected, 0 errors)
2026-10-05 route: complete J15 pin 165-173 bridge and IC ground return link on F.Cu (67 -> 65 unconnected, 0 errors)
2026-10-05 route: complete CAM_L sensor shield ground fanout via and link on B.Cu (0 errors, 633 warnings)
2026-10-05 route: complete U6 thermal ground plane fanout via on B.Cu (65 -> 64 unconnected, 0 errors)
2026-10-05 route: complete CAM_L pad 16 and SH ground fanout via and links on B.Cu/F.Cu (64 -> 63 unconnected, 0 errors)
2026-10-05 route: complete J15 pad 50 ground fanout via and link to planes (63 -> 62 unconnected, 0 errors)
2026-10-05 route: complete U4 thermal ground pad link on F.Cu (62 -> 61 unconnected, 0 errors)
2026-10-05 route: complete CAM_I2C_SCL pullup link to camera I2C bus via In2 (60 -> 59 unconnected, 0 errors)
2026-10-05 route: complete CAM_R shield ground via and link on B.Cu (58 -> 57 unconnected, 0 errors)
2026-10-05 route: tie C16/U1 ground branch to ground plane via F.Cu (57 -> 56 unconnected, 0 errors)
2026-10-05 route: connect C23 pad 2 ground link on F.Cu (56 -> 54 unconnected, 0 errors)
2026-10-05 route: tie C15 pad 2 ground to internal planes with clean dogleg on F.Cu (55 -> 54 unconnected, 0 errors)
2026-10-05 route: tie R74 ground track on B.Cu to internal planes (54 -> 53 unconnected, 0 errors)
2026-10-05 route: stitch Zone 1 GND island on B.Cu to internal planes (53 -> 52 unconnected, 0 errors)
2026-10-05 route: tie U6 pin 1 to pin 7 5V_VIN power rail via In2_SINGAL (52 -> 51 unconnected, 0 errors)
2026-10-05 route: tie FB1/C22 5V_VIN input to main U6 5V_VIN rail via In2 and F.Cu (51 -> 50 unconnected, 0 errors)
2026-10-05 route: complete Net-(IC7-CURRENT_MODE) from IC7.3 to R54.2 via In2_SINGAL (50 -> 49 unconnected, 0 errors)
2026-10-05 route: connect #RESET from R39.1 to right-side reset circuit via In2_SINGAL (49 -> 48 unconnected, 0 errors)
2026-10-05 route: bridge #RESET bus between In5 and In2 via 111.00mm corridor, fully closing #RESET net (48 -> 47 unconnected, 0 errors)
2026-10-05 route: connect IC7 thermal ground pad to In4/In6 internal GND plane via (47 -> 45 unconnected, 0 errors)
2026-10-05 route: connect R137 pin 2 GND to internal GND via on B.Cu (46 -> 45 unconnected, 0 errors)
2026-10-05 route: connect IC12/IC13 ground to internal GND planes via F.Cu stub and via (44 -> 43 unconnected, 0 errors)
2026-10-05 route: connect C41 pin 2 ground to internal GND planes via F.Cu stub and via (43 -> 42 unconnected, 0 errors)
2026-10-05 route(pwr): connect IC18 pin 15 HDMI_PWR via B.Cu bridge (40 -> 39 unconnected, 0 errors)
2026-10-05 route(pwr): connect U4 TCA9548A pin 21 and C9 to 3V3_SYS distribution rail on F.Cu (39 -> 38 unconnected, 0 errors)
2026-10-05 pcb: enable HDI blind/microvias and set DFM constraints (0.1mm drill / 0.25mm pad)
2026-10-05 pcb: route Milestone 25 - ground breakout microvias for J5.5 and J15.176 (38 -> 36 unconnected)
2026-10-05 pcb: route Milestone 26 - HDMI_SHIELD J1 pin 7 and pin 10 microvias to In1 bus (36 -> 34 unconnected)
2026-10-05 pcb: route Milestone 27 - /Supply/5V_SS microvia breakout to In5 (34 -> 33 unconnected)
2026-10-05 pcb: route Milestone 28 - IC7 pin 8 3V3_SYS microvia bridge on In2 (33 -> 32 unconnected)
2026-10-05 pcb: route Milestone 29 - IC7 pin 22 /USB/USBC_ADDR microvia link to TP21 on In2 (32 -> 31 unconnected)
2026-10-05 pcb: route Milestone 30 - Net-(J1-GND) microvia route on In3 (31 -> 30 unconnected)
2026-10-05 pcb: route Milestone 31 - TMDS_SCL_5V0 microvia link on In2 from J1.17 to B.Cu bus (30 -> 29 unconnected)
2026-10-05 pcb: route Milestone 32 - TMDS_D1_C_P differential pair microvia route on In3 (29 -> 28 unconnected)
2026-10-05 pcb: route Milestone 33 - Net-(U4-SDA) microvia route on In2 between R57 and U4 (28 -> 27 unconnected)
2026-10-05 pcb: route Milestone 34 - Ground CAM_L pin 19 to In6_GND via B.Cu microvia (27 -> 26 unconnected)
2026-10-05 pcb: route Milestone 35 - Net-(IC7-PORT) microvia route on In2 between IC7 pad 4 and R55 pad 2 (26 -> 25 unconnected)
2026-10-05 pcb: route Milestone 36 - /USB/C_CC2 microvia route on In3 between D5.1 and R66.2/R65.2 (25 -> 24 unconnected)
2026-10-05 pcb: route Milestone 37 - 2V8_CAM microvia route on In5 between U10.5 and C92.1 (24 -> 23 unconnected)
2026-10-05 pcb: route Milestone 38 - 2V8_CAM microvia route on In5/B.Cu to CAM_R pad 10 (23 -> 22 unconnected)
2026-10-05 pcb: route Milestone 39 - 1V2_CAM microvia route on In2/B.Cu to CAM_L and ground shield tab (22 -> 21 unconnected)
2026-10-05 pcb: route Milestone 40 - Ground J15 pin 56 to In4_GND via F.Cu microvia (21 -> 20 unconnected)
2026-10-05 pcb: route Milestone 41 - Complete 2V8_CAM network to CAM_L pad 10 on In2 (20 -> 19 unconnected)
2026-10-05 pcb: route Milestone 42 - Complete 1V2_CAM bus across camera core via In2 and B.Cu bypass (19 -> 18 unconnected)
2026-10-05 pcb: route Milestone 43 - Connect R91.2 to /Supply/5V_VIN via In3 microvia bridge (18 -> 17 unconnected)
2026-10-05 pcb: route Milestone 44 - Complete /CSI/CAM_I2C_SDA bus to CAM_R pad 30 across In2 (17 -> 16 unconnected)
2026-10-05 pcb: route Milestone 45 - Connect U6 V_SNS to R93.1 via In5 microvia bridge (16 -> 15 unconnected)
2026-10-05 tools: add route_engine and staged_route_runner helpers
2026-10-06 fix(pcb): Milestone 61 - eliminate co-located holes and dangling vias (DRC verified, holes: 0, dangling_vias: 0)
2026-10-06 fix(pcb): Milestone 62 - trim 21 GND fanout stubs and 8 signal tracks (DRC verified, track_dangling: 0)
2026-10-06 fix(pcb): Milestone 63 - relocate 88 silkscreen designators away from exposed pads (DRC verified, silk_over_copper: 0)
2026-10-06 fix(pcb): Milestone 64 - resolve 69 silkscreen overlaps and normalize font to JLCPCB specs (DRC verified)
2026-10-06 feat(pcb): Milestone 65 - configure JLCPCB plot parameters with subtractmaskfromsilk and Excellon drill setup
2026-10-06 chore(pcb): Milestone 66 - final full-board zone refill and zero-defect DRC sign-off for JLCPCB manufacturing
2026-10-06 feat(3d): remediate misaligned SMD passives across 7 footprint families to identity
2026-10-06 feat(3d): remediate IC packages (SOT-23-5, R-PDSO-N15, SOT-23-6) and update USON-10 to official KiCad model
2026-10-06 fix(Jetson-AI-Cam-CopperPilot.kicad_pcb): 3d models
2026-10-06 chore(pcb): baseline board outline with rounded edge cuts
2026-10-06 refactor(pcb,sch): remove all 36 test points and prune associated stub tracks
2026-10-06 feat(3d): upgrade stereo camera modules to substantial M12-mount CAD models with multi-material optical assembly
2026-10-06 feat(silkscreen): add CopperPilot logo, product title, B=39mm baseline dimension, and L/R channel badges
2026-10-06 feat(3d): upgrade stereo camera modules to oversized ⌀22mm industrial M12 lens assemblies
    - Synthesize 3D STEP and VRML models for Arducam M25170H12 industrial low-distortion lens (⌀22.0mm OD, 24.7mm H, ⌀13.2mm convex AR optical dome, stepped knurled barrels with titanium accent trims)
    - Update CAM_L and CAM_R 3D model associations to Camera_Module_IMX219-M12-Large.step
    - Reposition (L) and (R) silkscreen badges to Y=119.5mm for clean clearance reveal beneath the enlarged lens bell
    - Verify 100% net continuity (0 unconnected items) and 0 DRC regressions via kicad-cli
2026-10-09 fix(sch): surgically repair S-expression quote syntax errors across 5 hierarchical sheets
    - Fix unescaped double-quote in Spacer_Drill3.7mm_H4mm description on interfaces.kicad_sch line 1459
    - Remove backslash-escaped quotes in symbol definitions and lib_id references across display, id-serial, som, and usb-debug sheets (332 lines)
    - Restore clean hierarchical schematic loading in KiCad 10 GUI and CLI
    - Verified with kicad-cli sch export netlist (full 300 components / 437 nets recovered) and sch erc
2026-10-14 fix(schematic): remediate camera clocking, power sequencing, and ERC errors
    - Connect Sony IMX219 master clocks (CAM0/1_MCLK) from SoM pins 116/122
    - Connect independent PWDN hardware resets from SoM pins 114/120
    - Isolate sensor I2C channels (CAM0/1_SCL/SDA) downstream of PCA9547
    - Upgrade U11 digital core LDO to TLV75512PDBVR (500mA rating)
    - Ground R132 to enable serial EEPROM write-protect
    - Connect 3V3_SYS power rail to CAN transceiver U7 and fuse F5
    - Eliminate dangling global labels across all sheets
    - Configure 25 mil connection grid and achieve 0 ERC errors
2026-10-14 fix(pcb): synchronize netlist with schematic and clean layout defects
    - Reconcile 48 schematic parity net conflicts across CSI and camera control
    - Prune single-layer dangling stubs on 5V0_DBG and 1V2_CAM
    - Sever 1V8_SYS short circuits to CAM_L and CAM_R PWDN pins
    - Disconnect legacy camera I2C routing to isolate multiplexed channels
    - Ground EEPROM write-protect R132 fanout
    - Achieve 0 schematic parity errors and 0 DRC errors
2026-10-14 fix(csi): upgrade U11 to TLV75512, add local decoupling, I2C pull-ups, PWDN pull-downs, and DNP R34/R35
2026-10-14 fix(supply): ground J12 tabs, DNP U5 aux buck, add VIN/VSNS PWR_FLAG, and prune 10 wire stubs
2026-10-14 fix(phase1): resolve all schematic defects across som, usb, supply, csi, id-serial with zero ERC errors
2026-10-14 fix(csi): connect R15 pin 2 to CAM0_SCL label
2026-10-14 fix(footprint): correct R_0402_1005Metric.kicad_mod formatting
2026-10-14 fix(phase2): sync PCB netlist, resolve all 48 net parity conflicts, add missing passives, and prune dangling stubs
2026-10-15 fix(phase3): resolve all 25 shorting items, eliminate solder mask bridges and courtyard overlaps, reposition decoupling and pull-ups to B.Cu
2026-10-15 fix(schematic): resolve electrical omissions, CSI pairs, CAN power, DNP flags, and ERC stubs
2026-10-15 fix(pcb): synchronize CSI differential pair net assignments on J15 connector
2026-10-15 fix(pcb): route CSI differential pairs to J15 connector pads
2026-10-16 fix(sch): ground EEPROM WP, mark unused stubs as no-connect, and resolve all ERC warnings
2026-10-16 fix(pcb): prune dead-end stubs and shift R145 to clear silkscreen violation
2026-10-16 feat(pcb): connect DC input fuse, TVS diode, main VIN bus, and 3V3 decoupling
2026-10-16 feat(pcb): complete in-line PCIe AC coupling differential routing and prune stubs
2026-10-16 feat(pcb): connect camera decoupling and power rails on B.Cu and In2
2026-10-16 feat(pcb): connect camera GND bypass returns, C95 1V8 power, and CSI I2C pullup pairs
2026-10-16 feat(pcb): connect C100 1V2 bypass capacitor on B.Cu and In3
2026-10-16 feat(pcb): route 1V8 power distribution to pull-up bank and IC6 level shifter
2026-10-16 feat(pcb): connect C96 1V2 bypass capacitor on B.Cu and In3
2026-10-16 feat(pcb): route /CSI/CAM_I2C_SCL bus from J15 to R35 pullup
2026-10-16 feat(pcb): route /CSI/CAM_I2C_SDA bus from J15 to R34 pullup
2026-10-16 feat(pcb): connect right camera 1V8 power rail to In5 distribution trunk
2026-10-16 feat(pcb): connect C99 1V8 bypass cap and prune dangling via
2026-10-16 feat(pcb): connect CAM0_PWDN between left camera and pull-down resistor R144
2026-10-16 feat(pcb): route CAM1_PWDN from J15 to right camera and pull-down resistor R145
2026-10-16 feat(pcb): connect CAM0_SCL from left camera to pull-up resistor R140 on B.Cu
2026-10-16 fix(router): safely read via diameter in KiCad 10 pcbnew without layer argument
2026-10-21 feat(release): resolve all ERC/DRC/parity issues, complete 8-layer routing, and generate JLCPCB fab outputs
    Resolve all schematic ERC violations, PCB DRC errors/warnings, schematic-to-PCB parity mismatches, and LCSC BOM/CPL fields, and package 8-layer Gerbers, drills, BOM, and CPL for JLCPCB manufacturing.
2026-10-21 fix(sch): resolve label, wire, and property collisions on Root, ID Serial, and Interfaces sheets
    Remove duplicate overlapping global labels on GEN0_SDA, GEN0_SCL, and 3V3_SYS, delete off-sheet stray artifacts, reposition R71/R101/C13 properties out of wire corridors, clear J14 MP pin number from vertical GND drop, and align hierarchical sheets to 1.27mm grid.
2026-10-21 fix(sch): resolve all symbol, label, property, and frame collisions on CSI sheet (Page 3)
    Fix IMX219_30P symbol body height and SH pin placement, add wire stubs and outward justifications on all CAM_L/CAM_R/J15B/U4 global labels, rotate side GND symbols outward, unstack C95-C102/R140-R145/C91-C94/R13-R61 properties, shift U11 LDO block for clearance, and delete 24 stray junctions and 5 stray polylines.
2026-10-21 fix(sch): resolve all symbol, label, and property collisions on SoM sheet (Page 4)
    Flip J10 PCIe global labels outward, stagger C103/C104 and move properties out of wire bundle, shift R112 to clear USR1 value text, hide internal pin text on BSS138PW and BAT1, stagger SP1-SP6 spacer labels, align J15A/J15C/J15F labels, and preserve 100% PCB schematic parity.
2026-10-21 fix(sch): resolve all PWR_FLAG, label, and differential-corridor collisions on Display sheet (Page 5)
    Remove duplicate TMDS_HPD label on J15E, relocate colliding PWR_FLAG symbols on J1/J2/IC2/top-left and hide flag text, move C73-C80/R1-R10/C39-C45/R98-R99 properties out of differential wire corridors, clean up R31/R32/T1, and delete stray off-sheet artifacts.
2026-10-21 fix(sch): resolve all symbol, label, property, and syntax collisions on Supply sheet (Page 6)
    Fix unquoted COMP pin name in SIC477ED-T1-GE3, relocate #FLG0313 and #FLG0312 PWR_FLAGs, move R93/C61/R96/R76/R44/R70/L1/U1/U5/IC4/U3 properties out of bodies and wires, fix R117 table box, hide J4 duplicate Description, remove duplicate PWR_EN label and J12 MP1/MP2 no_connect conflicts, and delete stray off-sheet artifacts.
2026-10-21 fix(sch): resolve all symbol, label, property, table, and off-sheet collisions on USB sheet (Page 8)
    Reposition colliding resistor/capacitor properties, PWR_FLAG symbols, ESD array labels, load switch framing boxes, and OTG truth table borders on usb-debug.kicad_sch while removing off-sheet stray elements and preserving 100% electrical connectivity.
2026-10-21 docs(sch): add before/after schematic comparison renders across all 8 sheets
    Update final schematic renders and add side-by-side before/after comparison images for all 8 schematic sheets in docs/images/schematic-comparisons/.
2026-10-23 fix(sch): configure U2 3.3V buck feedback divider and tune POWER_EN boot delay
    Set R48 to DNP and populate R118/R119/R45/C24 divider network to ensure 3.3V regulation from LMQ62440 1.0V internal reference. Retune R85 to 10k for 100ms POWER_EN boot delay.
2026-10-23 fix(bom): update LCSC procurement part numbers and SMT assembly flags
    Reconcile LCSC part numbers with physical land patterns and active stock:
    - J11 USB-C: C456013 (24-pin SuperSpeed receptacle matching Wurth 632723300011)
    - J15 SODIMM: C2766246 (TE 2309413-1 260-pin socket)
    - J2 Mini-DP: C574827 (TE 2129320-3)
    - J1 Micro-HDMI: C563878 (Molex 467651001)
    - J5, J9 Micro-USB: C132560 (Molex 473460001)
    - REC1, RST1, USR1: C2886925 (E-Switch TL3340AF160QG)
    - BAT1: set DNP for SMT reflow to prevent thermal rupture in 260C oven
2026-10-23 build(fab): regenerate manufacturing Gerbers, drill maps, and release archive
    Update RS-274X Gerber layers, Excellon drill files, and gerbers.zip with latest component attributes, DNP flags, and LCSC procurement properties.
2026-10-23 docs(review): update visual inspection assets, diff maps, and verification report
    Update final schematic and PCB layer renders, synchronize visual diff change maps with 0 unexplained regions, and archive deep-dive inspection assets.
2026-10-24 fix(sch,pcb): connect EEPROM C36 bypass directly to EEPROM_PWR rail
    Reconnect decoupling capacitor C36 to net /ID Serial/EEPROM_PWR on schematic and PCB B.Cu layout, placing bypass charge reservoir downstream of steering diode D15 at IC17 VCC pin 4.
2026-10-24 fix(sch,pcb): populate level translator decoupling bypass capacitor C5
    Remove DNP exclusion from 100nF bypass capacitor C5 on display interface level translator IC11 (SN74LV1T125) on schematic and PCB layout, adding C5 to production BOM with LCSC C1525.
2026-10-24 fix(sch): eliminate text and symbol wire collisions on power supply sheet
    Relocate '9...36 VDC' input voltage text annotation clear of input header J4 return path and hide unformatted MPN text on fuse F3 to eliminate high-current wire corridor collisions on supply sheet.
2026-10-24 fix(sch): relocate R64 designator clear of USB power wire corridor
    Shift R64 reference designator to (350.52, 40.0) centered above resistor body, eliminating wire corridor collision on USB & debug sheet.
2026-10-24 docs(mech,dfm): record mechanical keepout clearances and assembly envelope specifications
    Formalize decisions DEC-010 through DEC-016 and manufacturing constraints for M2.5 spacer screw head envelopes, M12 lens mount base dimensions, and perimeter tactile switch lateral clearances.
2026-10-24 build(fab,review): refresh manufacturing gerbers, release archive, and visual proof diff crops
    Update production Gerbers, drill maps, IPC-D-356 netlist, and release zip for C36 EEPROM bypass rerouting and C5 population. Add before/after/diff visual proof crops for SCH-002, SCH-003, SCH-005, SCH-007, and PCB-006 to review register and HTML report.
2026-10-24 chore(repo): ignore temporary ERC/DRC verification reports
    Ignore transient test artifacts generated by kicad-cli during acceptance testing.
2026-10-24 docs(review): record pull request documentation template
    Track PR description document with change matrices and verification evidence.
