CopperPilot/Jetson-AI-Cam-CopperPilot/(notices)

Notices in the files:
3dmodels/9774040151.step:
Copyright (C) 2025, KiCAD
This work is licensed under the
[Creative Commons CC-BY-SA 4.0 License](https://creativecommons.org/licenses/by-sa/4.0/legalcode),
with the following exception:
project files under this or any other license agreement. However, if you wish to distribute
parts and their libraries:
License: Apache-2.0
